CamFo/SecurityDoor/Door/Schéma/Mesure/M1 Porte derrière.jpg

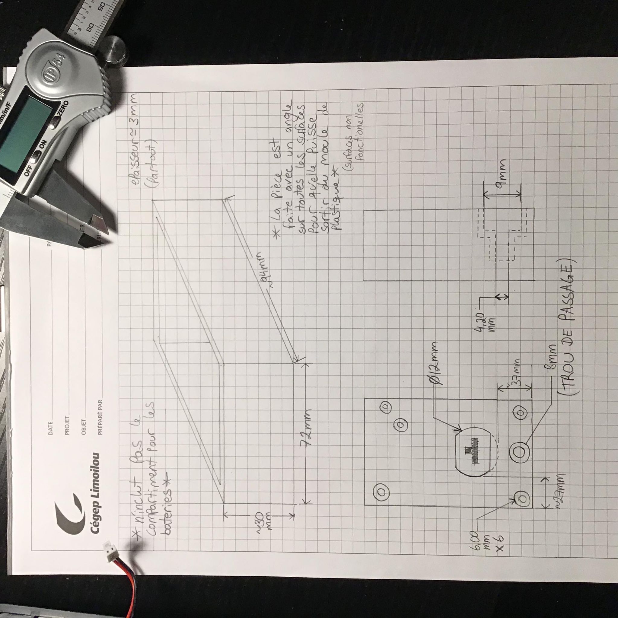
Door/Schéma/Mesure/M1 Porte derrière.jpg
