CamFo/SecurityDoor/Door/Schéma/Fusion 360/3.JPG

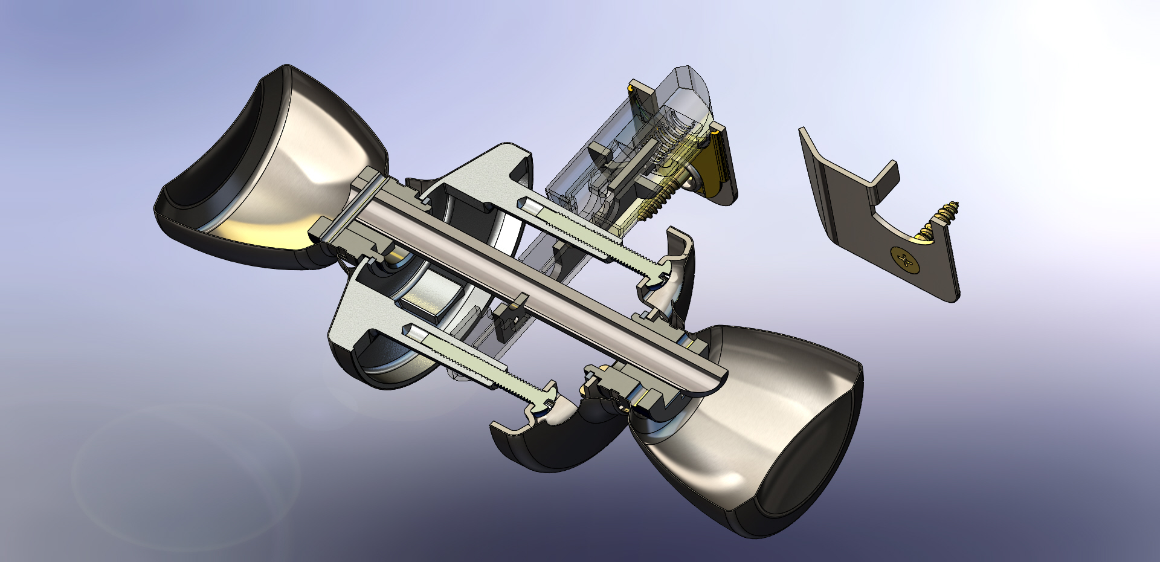
Door/Schéma/Fusion 360/3.JPG
