CamFo/SecurityDoor/README.md

# SecurityDoor
The repository to put all file necessary for the final project of TSO
