CamFo/SecurityDoor/Door/Schéma/Revue de conception/liste_de_revue_de_conception.xlsx

Sheet: Schéma électrique
Revue Conception
Date: | 2023-04-17
Responsable:
Participants: | Ilyes Gharmoul
Schéma Électrique |  |  |  | C/NC/NA
item | Détails de vérification | Catégorie | Requis | Conformité | notes
1 | La cartouche a été bien remplie identifiant le nom du projet, nom de l'organisation, le nom du PCB, le nom du dessinateur, une date de révision | dessin |  | Conformité
2 | La patte 1 de tous les connecteurs est identifiée clairement et définie au niveau de l'empreinte(footprint) | dessin |  | Conformité | J4 de la page de drive moteur est techniquement conforme mais possède les pins "L et R" pour Left and Right pour souder le connecteur au ground (les supports)
3 | Vérifier que chaque pièce est bien liée a la bonne empreinte dans Altium. | dessin |  | Conformité
4 | Identifier tous footprint non standards (gros condensateurs, grosses résistances) | dessin |  | NA | Tous standards
5 | Les pattes d'alimentation et de ground (terre) sont bien définis. Les traces critiques (puissance, impedances controlées, bus) identifiées | dessin |  | Conformité | seul grande puissance potentielle (>1A) est la bande LED sinon il y a le USB qui doit avoir du differentiel
6 | Les symboles d'alimentation ne sont pas dirigés vers le bas et les symboles de gnd ne sont pas dirigés vers le haut | dessin |  | Conformité
7 | Vérifier qu'il n'y a pas d'entrées flotantes (ampli-op), grille de mosfet, entrées de IC | dessin |  | Conformité
8 | Vérifier les pattes des connecteurs lorsque deux cartes s'emboitent ensemble ou s'ils sont reliés par des câbles. Attention aux effets mirroirs | dessin |  | NA | Les connecteurs que j'utilise fait en sorte que s'est impossible d'inverser la connection
9 | Vérifier qu'il n'y a pas d'interférence (overlap) sur le schéma électrique | dessin
10 | Les valeurs sont-elles dans un format uniforme (résistances, condensateurs, inductances) | dessin |  | Conformité
11 | Tous les composants ont une référence et une valeur | dessin |  | Conformité
12 | Les symboles des composants sont suffisamment clairs et donnent suffisamment d'information | dessin |  | Conformité
13 | Les symboles de composants identiques sont les mêmes d'un circuit et d'une page à l'autre (attention aux copies collés) | dessin |  | Conformité
14 | Les pièces non-montées sont clairement identifiées sur le schéma électrique | dessin |  | Conformité
15 | Les références des composants utilisent des standards et sont uniformes sur tout le schéma électrique | dessin |  | Conformité | Les pièces non montées sont indiquée et les pièces qui seront peux être pas monter ( J7,J8 sur Enregistreur et Speaker Audio) aussi.
16 | On n'utilise pas de point décimaux (elles pourraient disparaitre dans le processus d'impression) | dessin |  | Conformité
17 | Les points de jonction sont présents, clairement identifiés et respectent les normes (pas de connexions en 4 voix) | dessin
18 | Les liens(nets) sont correctement branchés et accrochés sur le schéma électrique | dessin |  | Conformité
19 | Tous les liens orphelins doivent être identifiés ou éliminés | dessin |  | Conformité
20 | Le schéma est lisible lorsque imprimé dans le format de papier disponible | dessin |  | Conformité
21 | Le schéma devrait logiquement se lire gauche vers la droite, haut vers le bas | dessin |  | Conformité
22 | Les composants séparés en sections doivent être clairement identifiés (ampli, MCU, portes logiques) | dessin |  | Conformité | Ils sont séparer par page
23 | Les composants choisis sont-ils disponibles en quantité suffisante et prévus dans les délais | composants |  | Conformité
24 | Les composants choisis ont-ils des sources alternatives ou prévoir multiples empreintes | composants |  | Conformité | 2 type de conn USB, des connecteurs sur les IO au cas ou, et conn sur IDS au cas ou aussi.
25 | Les composants choisis sont-ils actifs (prévenir l'obsolescence) | composants |  | Conformité
26 | Les fiches techniques sont-elles facilement disponibles, claires et est ce qu'il y a des errata | composants |  | Conformité | et les datasheets sont dans notre database
27 | Vérifier les suffixes des composants choisis (footprint, température, précision) | composants |  | Conformité
28 | Vérifier que le bon type de condensateur soit utilisé (tantalum, electrolytique, ceramique) selon sa fonction | composants |  | Conformité
29 | Pour les composants SPI avec communication commune, est-ce qu'elles ont leur chip select connecté individuellement | signaux |  | Conformité
30 | Les fonctions de reset sont correctement filtrées | signaux |  | Conformité
31 | Vérifier les pull-up pour les bus I2C | signaux |  | Conformité
32 | Les différents bus et signaux sont-ils affectés aux bons ports et connecteurs | signaux |  | Conformité
33 | Vérifier les niveaux logiques des pattes digitales des IC (reset, select, disable, double fonctions) | signaux
34 | Vérifier s'il faut ajouter des pull-ups ou pull-down sur les pattes du MCU pour prévenir les problèmes lorsque le MCU est en reset (I/O haute impédance) | signaux |  | Conformité
35 | Les I/O des MCU sont clairement identifiées (sens des flèches: entrées ou sorties) | signaux |  | NA
36 | Des résistances en séries sont-elles nécessaires pour les signaux de communication rapides | signaux
37 | Pour des composants I2C, les adresses sont-elles définies et uniques | signaux |  | Conformité
38 | Les protections du circuit nécessaires sont-elles en place : Fusibles, diodes TVS | conception |  | Conformité
39 | Les règles électriques ont-elles été bien définies, respectées et validées (ERC) ? | conception |  | Conformité
40 | Vérifier la liste des connections (Netlist). Vérifier qu'il n'y a pas de liens orphelins ou un nom trop similaire(ex: 3V3 ou 3.3V) | conception |  | Conformité
41 | Vérifier la tension de tous les composants ( Condensateurs, régulateurs, protections) avec marge suffisante | conception |  | Conformité
42 | Est-ce que les règles de DRC sont bien définis et les erreurs DRC corrigés ou les avis (warnings) bien analysés | conception |  | Conformité
43 | Y-a-t-il des test points pour le gnd ainsi que pour les signaux critiques (I2C, UART, PWM,ADC, Alimentations) | conception |  | Conformité
44 | Les IC sont correctement découplés. Attention si plusieurs pattes d'alimentation sur un chip. La règle: 1 alim = 1 découplage | conception |  | Conformité
45 | Les entrées provenant de l'extérieur du PCB sont correctement protégés contre les DES(ESD) | conception |  | Conformité | TVS
46 | Les entrées sorties de cartes mémoires externes (ex: SD ou micro-SD) sont correctement protégées contre les DES(ESD) | conception |  | NA
47 | Les composants polarisés sont protégés contre une tension inverse | conception |  | NA | Connecteur rend la mauvaise polarisation impossible
48 | Les circuits permettant de programmer le MCU a été vérifié. Les I/O nécessaires prévus | conception |  | Conformité
49 | Des filtres sont-ils nécessaires entre des sections digitales et analogiques | conception |  | NA
50 | Des liens ''Spares'' sont tirés vers des tests points pour chaque MCU (idéalement 2) | conception |  | Conformité | Test poins et connecteurs sur les ios

Sheet: Circuit imprimé
Revue Conception
Date:
Responsable:
Participants:
Circuit imprimé
item | Détails de vérification | Catégorie | Requis | Conformité | notes
1 | Les composants sont le plus possible alignés suivant une grille et disposés 0,90,180,270 degrés | dessin
2 | Les composants sont facilement accessibles pour l'inspection, l'assemblage automatisé ou manuel et pour le remplacement | dessin
3 | Les boutons sont orientés logiquement, les potentiomètres orientés dans le même sens | dessin
4 | Des dégagements de cuivre et de tous métaux pour les modules RF avec antenne intégrés | dessin
5 | Des dégagements suffisants entre les pièces qui dégagent de la chaleur et les pièces sensibles à la température (ex: mems IMU) | dessin
6 | Un anneau de garde d'au moins 50 mils est prévu autour du pcb et un dégagement suffisant entre le cuivre et le contour extérieur au circuit imprimé | dessin
7 | Est-ce que des ''golds fingers'' sont nécessaires | dessin
8 | Le PCB doit-il être mis en panneau. Si oui, prévoir la méthode de dépannelisation | dessin
9 | Le ''Stackup'' est défini | dessin
10 | Le Fini du PCB est établi et le design en tient compte (or, étain, Argent, ROHS) | dessin
11 | L'épaisseur du fini est défini (1/2oz, 1oz…) attention aux trapèzes pour fini supérieur à 1 oz | dessin
12 | Les ouvertures dans le masque de soudure sont définies pour assemblage automatisé ou stencil | dessin
13 | Valider les tolérances du fabricant de PCB: ''solder mask'', ''silkscreen'', traces, trous, distance minimum entre les traces | dessin
14 | Au minimum trois ''Fiducials'' ont été ajoutés au PCB pour l'assemblage automatisé | dessin
15 | La patte 1 est clairement visible avant et après assemblage sur les IC | dessin
16 | Les composants polarisés (diodes, condensateurs, etc) sont clairement indiqués sur le circuit imprimé | dessin
17 | Pour les cartes de développement, un marquage a toutes les 5/10 pattes est suggérée | dessin
18 | Les dimensions de l'empreinte a été vérifiée par le dessinateur et aussi validé par un collègue(fortement recommandé): top ou bottom view, dimensios des pads, dimensions entre les pads, solder mask entre les pads, dimensions des trous, marquage, identification patte 1, dégagements sous la pièce si nécessaire, pads thermiques | dessin
19 | Gestion des pads thermiques exposés et gestion de la connexion sur le bon net avec suffisamment de vias | dessin
20 | Le ''outline'' du PCB est défini | dessin
21 | Éviter les angles parfaitement droits pour les contours (mettre des rayons de courbure). Cela nécessite une fraise très petite et augmente les coûts du pcb | dessin
22 | Toutes les traces sont connectées | dessin
23 | Les recommandations du manufacturier ont été suivi au niveau du placement des pièces pour les MCU, les convertisseurs, les régulateurs DC-DC, les modules RF, etc… | dessin
24 | Toutes les couches ont été vérifiés | dessin
25 | Des ''thermals reliefs'' sont ajoutés sur les pattes surtout reliées aux plans de masses et plans d'alimentation | dessin
26 | Il n'y a pas de traces à 90 degrés (acid traps) | dessin
27 | La grosseur des traces est adaptée au courant qui circule afin d'éviter l'échauffement ou les pertes de tension | dessin
28 | Les vias sont suffisament gros et adaptés à la grosseur des traces | dessin
29 | Le nom du circuit imprimé est indiqué et un espace pour numéro de série idéalement | dessin
30 | Les connecteurs ont des noms clairs pour aider le branchement | dessin
31 | Aucun ''silkscreen'' sur les pads | dessin
32 | Ne pas avoir de composants électroniques (IC, condensateurs, diodes) plus près de 50 mils du bord du PCB | dessin
33 | Les connecteurs de ''debug'' sont-ils accessibles | mécanique
34 | Les contraintes mécaniques ont été établies et vérifiés (dimensions pcb, bosses fixations, interférences mécaniques, connecteur, interface usager) | mécanique
35 | Les ''Keep out'' sont respectés autour des connecteurs, des trous de montage, des outils d'extraction, des outils de programmation, des outils d'assemblage (tournevis, etc) | mécanique
36 | Les trous de fixations sont-ils isolés électriquement, reliés à la masse ou a un autre ''net'' | mécanique
37 | Est-il possible de brancher débrancher facilement les connecteurs avec les doigts | mécanique
38 | Un modèle 3D a été validé dans le boitier mécanique du produit afin de valider la hauteur des pièces, les connecteurs, les trous de fixation | mécanique
39 | Les filtres sont proches de la source (transmetteur) | conception
40 | Les résistances de terminaison sont proches du recepteur | conception
41 | Les condensateurs de découplage sont placés le plus près possible des IC | conception
42 | Les masses analogiques et numériques sont reliés idéalement en un seul point | conception
43 | Le ERC a-t-il été passé, les erreurs corrigées ou analysées | conception
44 | Les traces à impédance contrôlées ont été gérés correctement | conception
45 | Les lignes de transmission sont gérées correctement | conception
46 | Y-a-t-il une ligne de garde autour des crystaux | conception
47 | Y-a-t-il des filtres sur les entrées ADC | conception
48 | 'Drivers'' et ''Receivers'' placés proche des connecteurs | conception
49 | Pas de traces autour des composants sensibles | conception
50 | Éviter les traces sous un composant bruité | conception
51 | Ne pas avoir de ''GND LOOP'' | conception
52 | Les pistes hautes tensions respectent les normes de sécurités applicables au produit | sécurité

Sheet: Bom
Revue Conception
Date:
Responsable:
Participants:
Bom
item | Détails de vérification | Catégorie | Requis | Conformité | notes
1 | Le bom a été généré et comprend au moins une révision, date de révision, nom du Bom, auteur | bom
2 | Les colonnes mimimales doivent être: item, qté, numéro manufacturier, description, référence (designator) | bom
3 | Des options peuvent aussi être ajoutées: numéro interne, coût, distributeur, manufacturier, status, empreinte, valeurs, SMT ou traversant | bom
4 | Vérifier qu'il n'y a pas de doublons dans les numéro de référence (designator) | bom
5 | Vérifier que la quanité inscrite correspond au nombre de numéro de référence (designator) | bom
6 | Vérifier qu'il n'y a pas de doublons de lignes dans les valeurs (ex: 0.1uF, resistances) | bom
7 | Vérifier si on peut remplacer une pièce par une autre pour faire diminuer le nombre de pièces (ex: pull-up ou condensateurs avec 2 footprints différents) | bom
8 | Identifier clairement dans le bom les pièces non-montées | bom
9 | Des notes de montages sont-elles nécessaires pour assembler le PCB | bom
10 | un fichier d'assemblage (XY) a été généré pour l'assemblage automatisé | bom

Sheet: Actions
Revue Conception
Date:
Responsable:
Participants:
Actions
No. | Détail de l'action | Responsable

Sheet: Liens utiles
Liens de référence
https://pcbchecklist.com/
PCB Layout & Routing (https://www.electronics-notes.com/articles/analogue_circuits/pcb-design/pcb-layout-routing.php)
EEVblog #1129 - Creating a Nice Readable Schematic (https://www.youtube.com/watch?v=R_Ud-FxUw0g)
How were schematics drawn before CAD? - Stack Exchange (https://electronics.stackexchange.com/questions/308878/how-were-schematics-drawn-before-cad)
https://www.volersystems.com/blog/design-tips/91-pcb-layout-checklist
