CamFo/SecurityDoor/Capteurs/Architecture/ArchitectureLogicielCapteurs.png

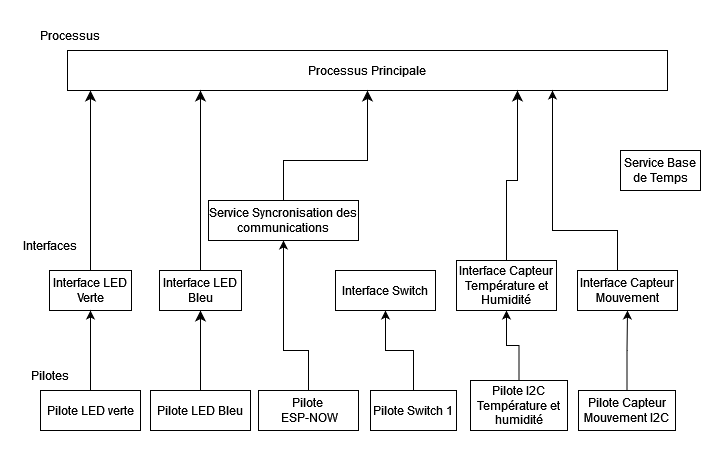
Capteurs/Architecture/ArchitectureLogicielCapteurs.png
