CamFo/SecurityDoor/Capteurs/Architecture/ArchitectureÉlectroniqueCapteurs.png

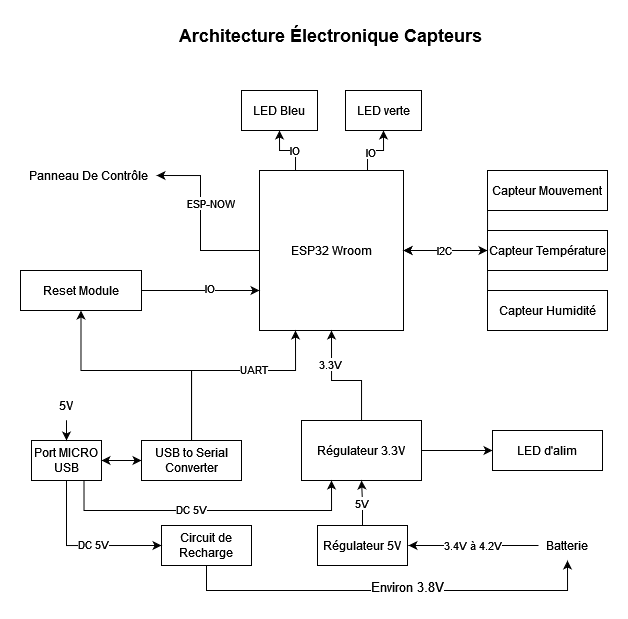
Capteurs/Architecture/ArchitectureÉlectroniqueCapteurs.png
