CamFo/SecurityDoor/Door/Schéma/Diagramme/Arch lo ex 1.drawio.png

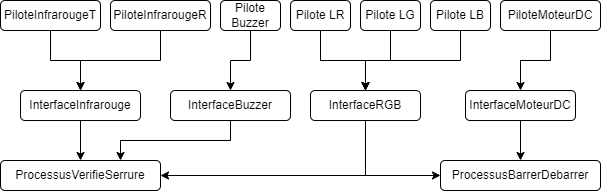
Door/Schéma/Diagramme/Arch lo ex 1.drawio.png
