CamFo/SecurityDoor/Door/Schéma/Diagramme/Arch lo ex 2.drawio (1).png

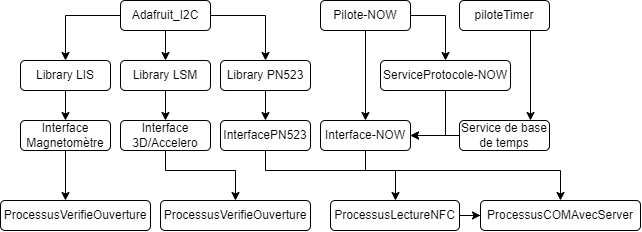
Door/Schéma/Diagramme/Arch lo ex 2.drawio (1).png
