CamFo/SecurityDoor/Door/Schéma/Diagramme/Architecture logicelle exclave.drawio (1).png

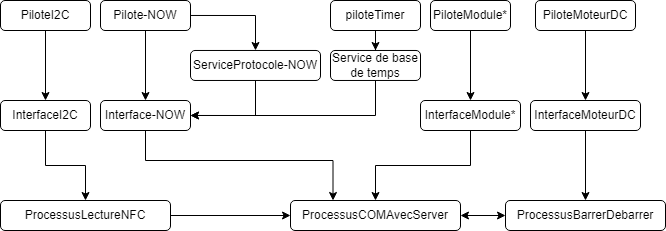
Door/Schéma/Diagramme/Architecture logicelle exclave.drawio (1).png
