CamFo/SecurityDoor/Door/Schéma/Diagramme/Architecture Materiel  Door.png

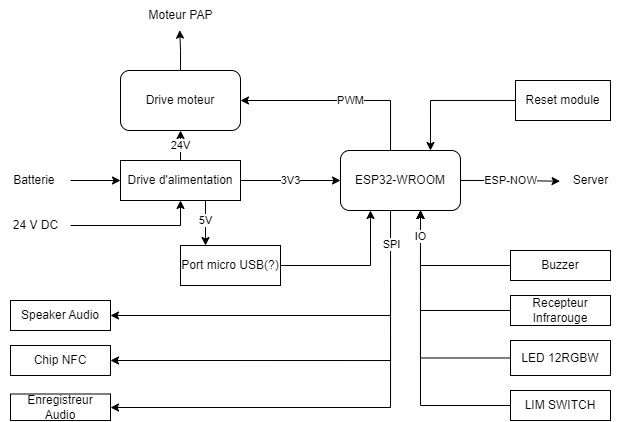
Door/Schéma/Diagramme/Architecture Materiel Door.png
