CamFo/SecurityDoor/Door/Schéma/Fusion 360/1.jpg

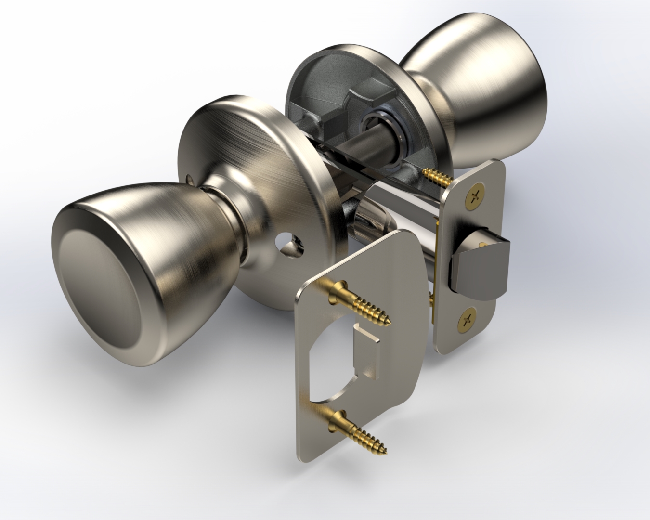
Door/Schéma/Fusion 360/1.jpg
