CamFo/SecurityDoor/Door/Schéma/Fusion 360/2.jpg

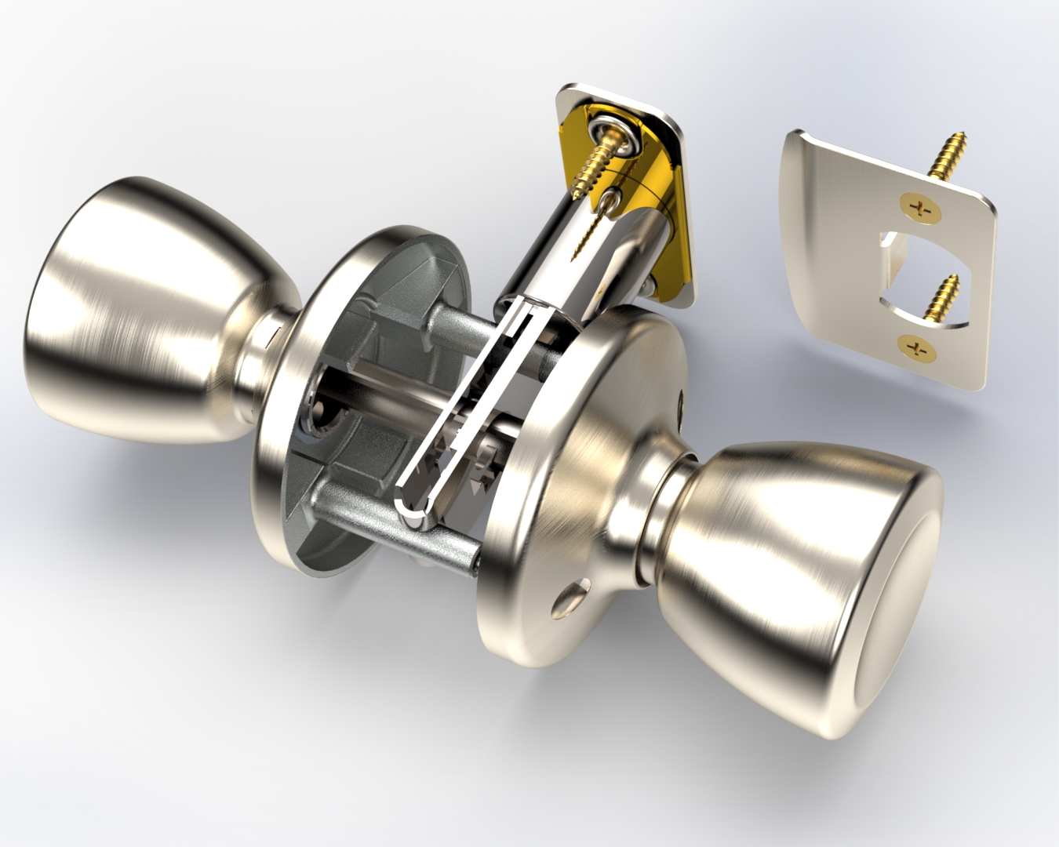
Door/Schéma/Fusion 360/2.jpg
