CamFo/SecurityDoor/Door/Schéma/Fusion 360/4.JPG

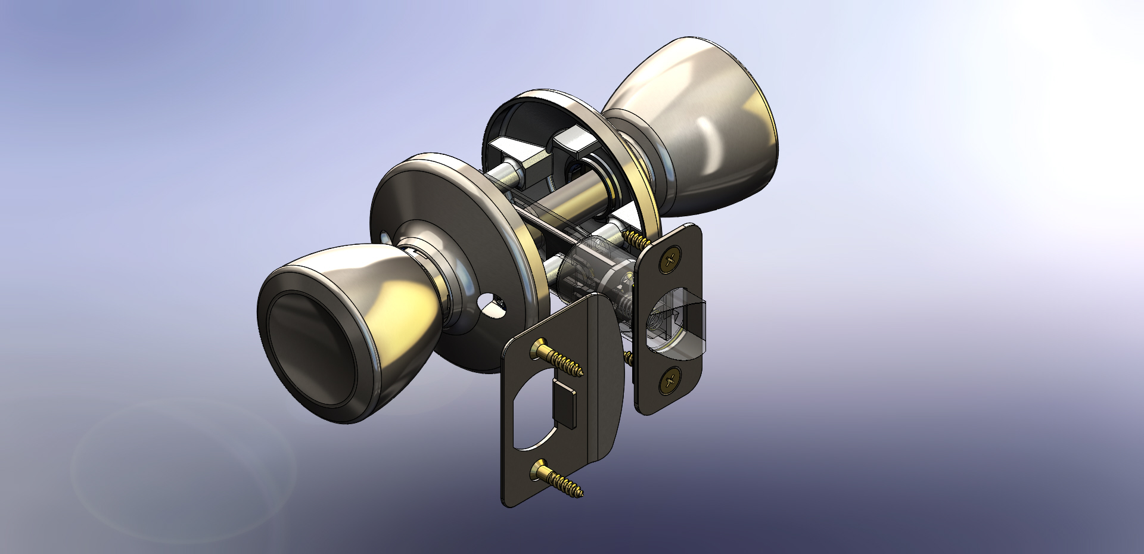
Door/Schéma/Fusion 360/4.JPG
