CamFo/SecurityDoor/Door/Schéma/Fusion 360/5.JPG

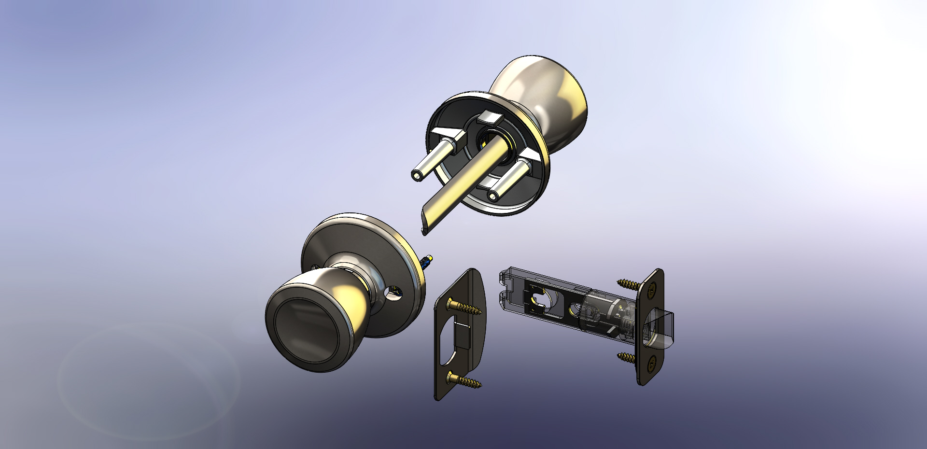
Door/Schéma/Fusion 360/5.JPG
