CamFo/SecurityDoor/Door/Schéma/Fusion 360/6.JPG

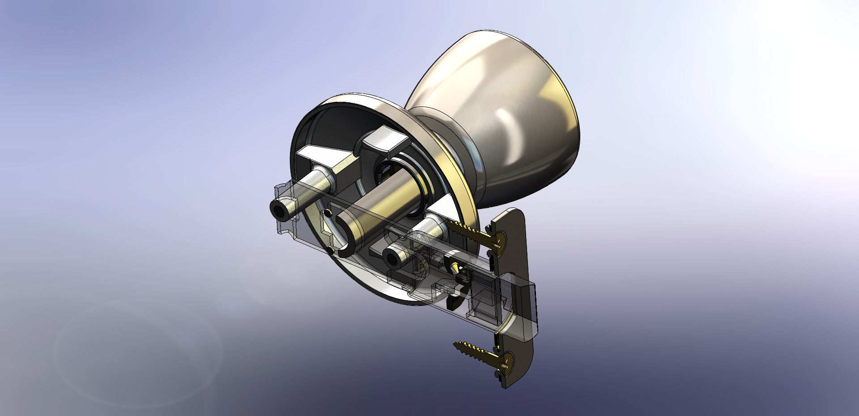
Door/Schéma/Fusion 360/6.JPG
