CamFo/SecurityDoor/Door/Schéma/Fusion 360/Rack and Pinion Gear Animated.gif

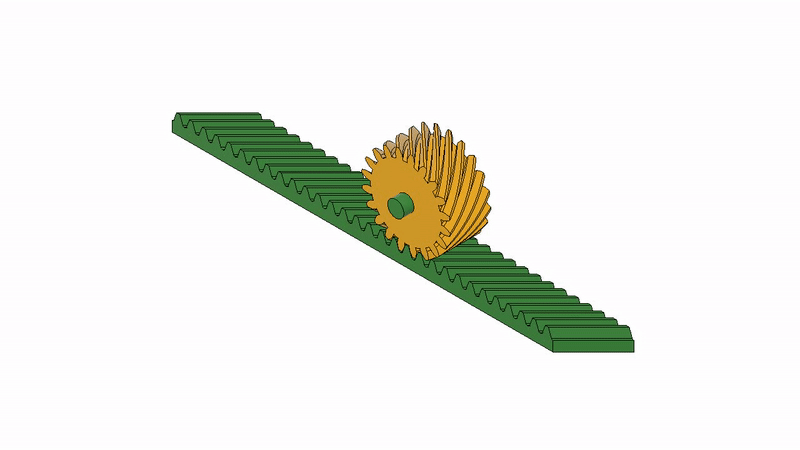
Door/Schéma/Fusion 360/Rack and Pinion Gear Animated.gif
