CamFo/SecurityDoor/Door/Schéma/Fusion 360/Rack and pinion gear drawing..jpg

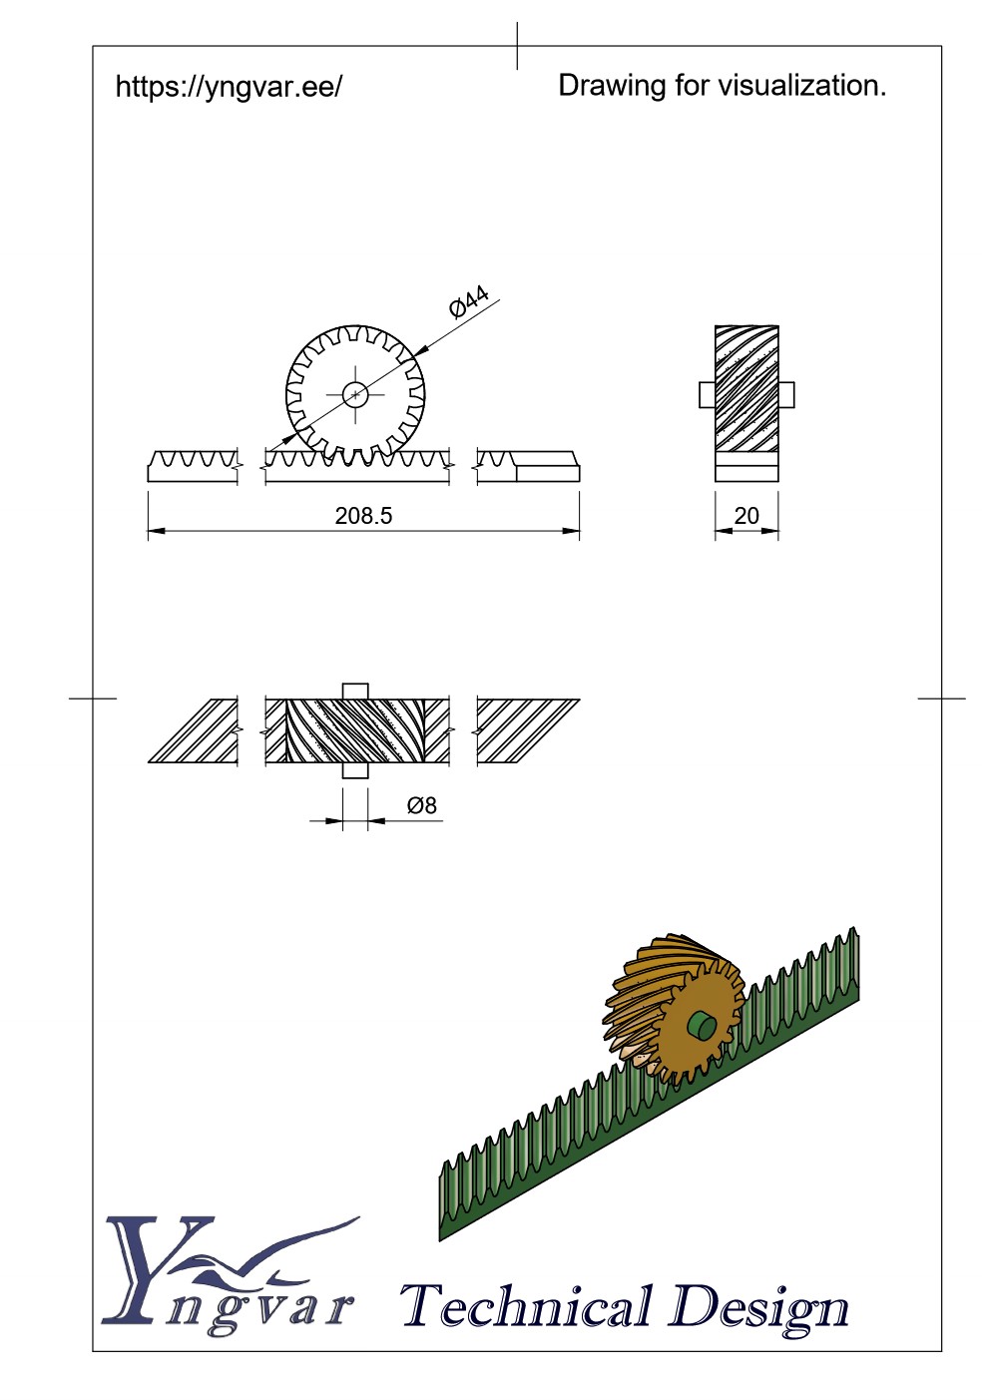
Door/Schéma/Fusion 360/Rack and pinion gear drawing..jpg
