CamFo/SecurityDoor/Door/Schéma/Fusion 360/Rack and Pinion Gear Transparent Image.png

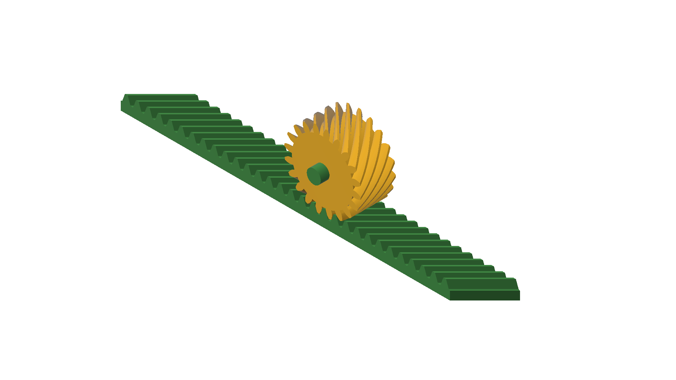
Door/Schéma/Fusion 360/Rack and Pinion Gear Transparent Image.png
