CamFo/SecurityDoor/Door/Schéma/Fusion 360/Rack and Pinion Gear..gif

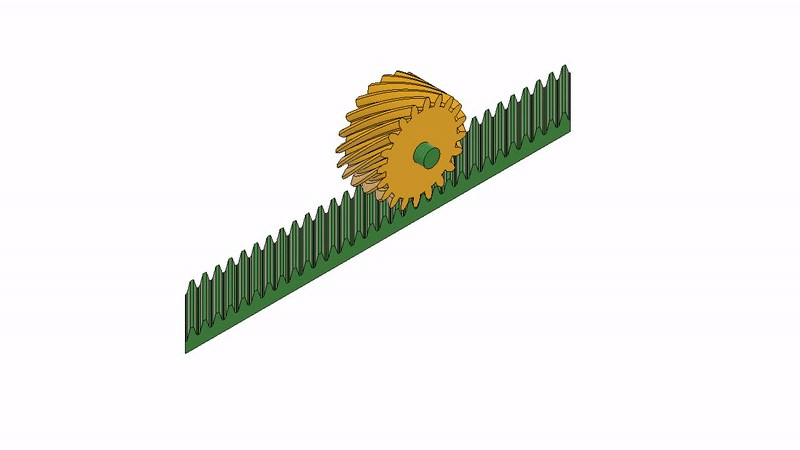
Door/Schéma/Fusion 360/Rack and Pinion Gear..gif
