CamFo/SecurityDoor/Door/Schéma/Fusion 360/Rack and Pinion Gear.jpg

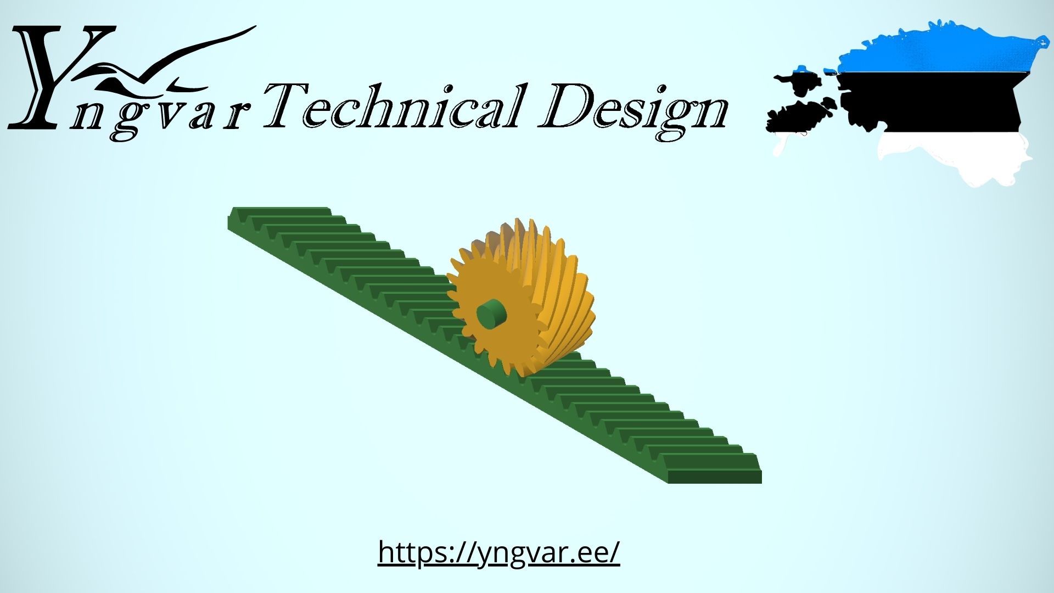
Door/Schéma/Fusion 360/Rack and Pinion Gear.jpg
