CamFo/SecurityDoor/Door/Schéma/Fusion 360/Rack and Pinion Gear.png

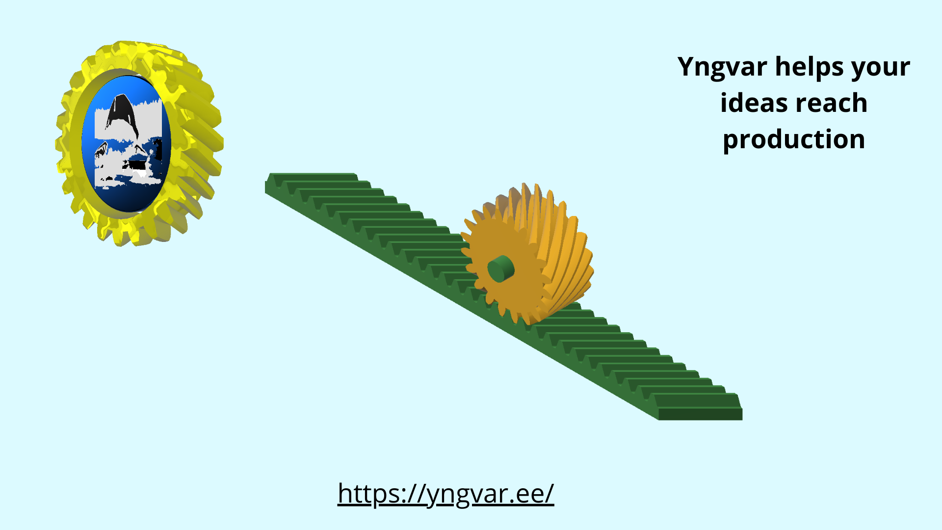
Door/Schéma/Fusion 360/Rack and Pinion Gear.png
