CamFo/SecurityDoor/Door/Schéma/Mesure/M2 Porte derrière.jpg

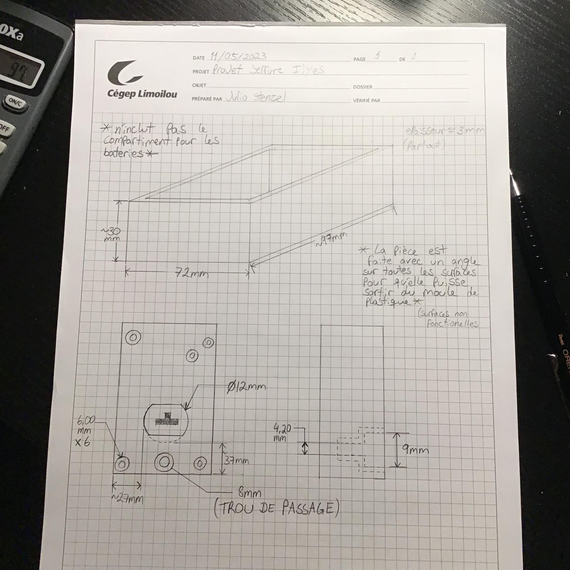
Door/Schéma/Mesure/M2 Porte derrière.jpg
