CamFo/SecurityDoor/Panneau/Architecture/ArchitectureLogicielPanneau.png

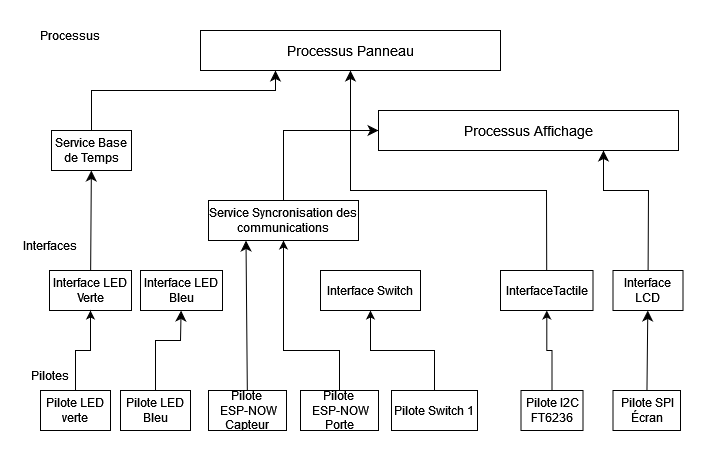
Panneau/Architecture/ArchitectureLogicielPanneau.png
