CamFo/SecurityDoor/Panneau/Architecture/ArchitectureÉlectroniquePanneau.png

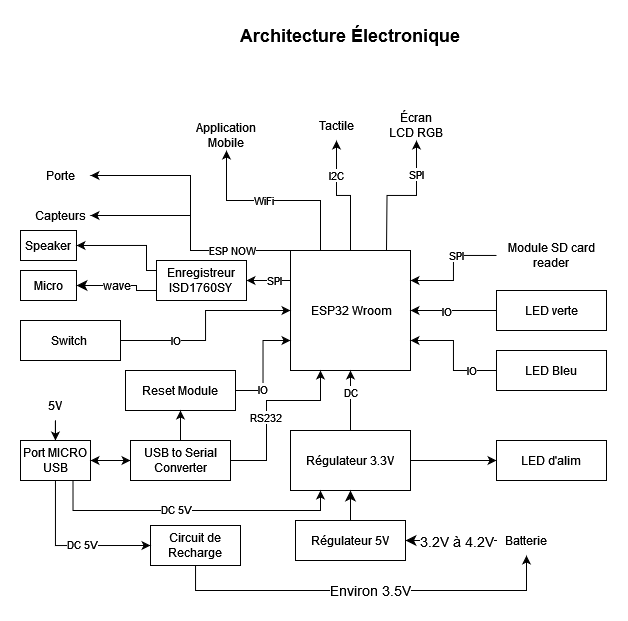
Panneau/Architecture/ArchitectureÉlectroniquePanneau.png
