CamFo/SecurityDoor/Schema Global/Architecture Systeme.drawio (1).png

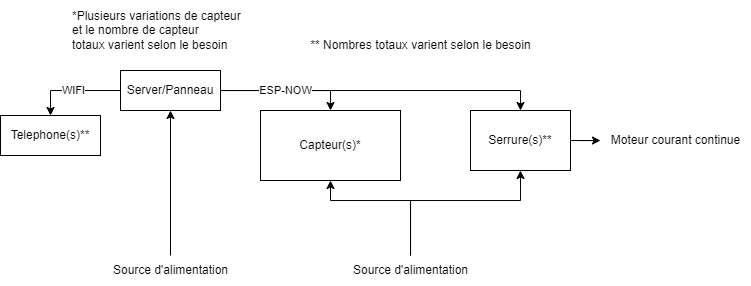
Schema Global/Architecture Systeme.drawio (1).png
