CamFo/SecurityDoor/Schema Global/Architecture Systeme.drawio.png

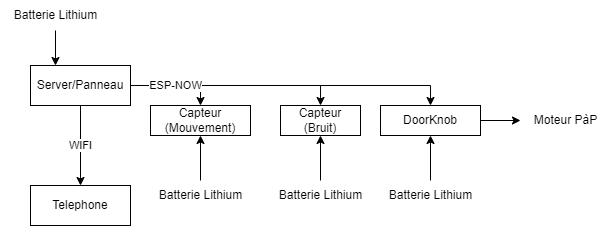
Schema Global/Architecture Systeme.drawio.png
