CamFo/SecurityDoor/Door/Altium/DPIAT202303_DOOR/BOM/DPIAT202303_DOOR.xlsx

Comment | Description | Quantity | Manufacturer Part Number 1 | ADAM Inventory Number 1
USB-UART CP2102N | USB Interface IC USBXpress - USB to UART Bridge QFN24 | 1 | CP2102N-A02-GQFN24 | E00002
USB - mini B | CONN RCPT MINI USB B 5POS SMD RA | 1 | 10033526-N3212LF | E00003
USB4105-GF-A | USB-C (USB TYPE-C) USB 2.0 Receptacle Connector 24 (16+8 Dummy) Position Surface Mount, Right Angle; Through Hole | 1 | USB4105-GF-A | E00005
TVS Diode 5.5V | 8.5V Clamp Ipp Tvs Diode Surface Mount SOT-143-4 | 1 | SP0503BAHTG | E00006
MMBT2222AM3T5G | TRANS NPN 40V 0.6A SOT-723 | 2 | MMBT2222AM3T5G | E00007
N-CH 30V 5.8A SOT23 | N-Channel 5.8A (Tj) 350mW Surface Mount SOT-23 | 1 | DMN3051L-7 | E00008
Dip Switch 3P | Dip Switch SPST 3 Position Surface Mount Slide (Standard) Actuator 25mA 24VDC | 2 | A6S-3102-H | E00009
TEST POINTS | RCWCTE TEST POINTS | 11 | RCWCTE | E00009
KMR741NG ULC LFS | SWITCH TACTILE SPST-NO 50MA 32V | 1 | KMR741NGULCLFS | E00012
499K | RES SMD 499K OHM 1% 1/4W 0603 | 1 | RC0603FR-07499KL | E00016
47K | RES SMD 47K OHM 5% 1/4W 0603 | 1 | AC0603FR-0747KL | E00017
21.5K | RES SMD 21.5K OHM 0.1% 1/5W 0603 | 1 | CRCW060321K5FKEA | E00018
150R | RES SMD 150 OHM 0.1% 1/8W 0603 | 5 | RC0603FR-07150RL | E00020
10K | RES SMD 10K OHM 1% 1/10W 0603 | 7 | RC0603FR-0710KL | E00021
100K | RES SMD 100K OHM 1% 1/4W 0603 | 2 | RC0603FR-07100KL | E00022
100R | RESISTOR 100 Ohm SMD 1% 1/10W | 1 | AC0603FR-10100RL | E00023
30R | RES 30 OHM 1% 1/3W 0603 | 1 | SG73P1JTTD30R0F | E00026
22.1K | RES 22.1K OHM 1% 1/10W 0603 | 1 | RMCF0603FT22K1 | E00027
1K | RES 1K OHM 1% 1/4W 0603 | 2 | SR0603FR-7T1KL | E00028
NA | No resistance, just in case | 7 | RC0603JR-070RL | E00032
MP28167GQ-P | Buck-Boost Switching Regulator IC Positive Fixed 5V 1 Output 3A 16-PowerVFQFN | 1 | MP28167GQ-P | E00033
LSM6DSMTR | Accelerometer, Gyroscope, Temperature, 6 Axis Sensor I²C, SPI Output | 1 | LSM6DSMTR | E00036
LIS3MDLTR | Magnetoresistive Sensor X, Y, Z Axis 12-LGA (2x2) | 1 | LIS3MDLTR | E00037
LD1117S33TR | IC REG LINEAR 3.3V 800MA SOT223 | 2 | LD1117S33TR | E00040
4.7 µH | FIXED IND 4.7UH 4.6A 53 MOHM SMD | 1 | SRP5030T-4R7M | E00042
Fuse 500mA | FUSE BOARD MNT 500MA 125VAC/VDC | 1 | 3413.0113.22 | E00043
ESP32-WROOM-32 (8MB) | No Description Available | 1 | ESP32-WROOM-32D-N4 | E00044
DRV8837CDSGT | Motor Driver NMOS PWM 8-WSON (2x2) | 1 | DRV8837CDSGT | E00045
B2B-PH-K-S(LF)(SN) | CONN HEADER VERT 2POS 2MM | 1 | B2B-PH-K-S-LF-SN | E00051
CONN JST 2P SM 90DEG | CONN SM JST 2P | 2 | S2B-PH-SM4-TB(LF)(SN) | E00052
B10B-PH-K-S(LF)(SN) | CONN HEADER VERT 10POS 2MM | 1 | B10B-PH-K-S(LF)(SN) | E00053
NPPN041BFCN-RC | CONN HDR 4POS 0.079 GOLD | 1 | NPPN041BFCN-RC | E00054
SSW-102-03-T-S | CONN RCPT 2POS 0.1 TIN | 1 | SSW-102-03-T-S | E00055
4.7 µF | CAP CER 4.7UF 25V X5R 0603 | 2 | CL10A475KA8NQNC | E00056
22nF | CAP CER 22pF 15V 10% 0603, X7R | 2 | EMF107B7223KAHT | E00057
1 µF | CAP CER 1UF 16V X7R 0603 | 3 | C0603C105K4RACAUTO | E00058
10 µF | CAP CER 10UF 6.3V X5R 0603 | 1 | GRM188R60J106ME47D | E00059
0.1 µF | CAP CER 0.1UF 50V X7R 0603 | 13 | C0603C104K5RAC7411 | E00060
10 µF | CAP ALUM 10UF 20% 16V SMD | 3 | UWX1C100MCL1GB | E00062
100 µF | CAP ALUM 100UF 20% 50V SMD | 5 | UWT1H101MNL1GS | E00063
PPTC121LFBN-RC | CONN RCPT 12POS 0.1 GOLD PCB | 3 | PPTC121LFBN-RC | E00067
Yellow | 0603 YELLOW | 1 | BL-HKC36D-AV-TRB | E00068
Red | 0603 RED LED | 3 | BL-HUB36A-AV-TRB | E00069
Green | LED GREEN 0603 SMD | 2 | 597-3316-507F | E00070
Blue | Blue 470nm LED Indication - Discrete 3.3V 0603 (1608 Metric) | 1 | APT1608LVBC/D | E00071
22 µF | CAP ALUM 22UF 20% 16V SMD | 1 | EEE-1CA220WAR
IR Sensor TSOP38338 | Ir Remote Receiver 38KHZ 45M 3-PIN | 1 | TSOP38338 | E00019
TSAL6100 | Infrared (IR) Emitter 940nm 1.35V 100mA 80mW/sr @ 100mA 20° Radial, 5mm Dia (T 1 3/4) | 1 | TSAL6100 | E00001
