CamFo/SecurityDoor/Door/Altium/DPIAT202304_FRONTDOOR/DPIAT202304_FRONTDOOR/BOM/DPIAT202304_FRONTDOOR.xlsx

Description | Comment | Quantity | Manufacturer Part Number 1 | ADAM Inventory Number 1
CAP CER 0.1UF 50V X7R 0603 | 0.1 µF | 6 | C0603C104K5RAC7411 | E00060
CAP ALUM 4.7UF 20% 35V SMD | 4.7 µF | 5 | EMVE350ADA4R7MD55G | E00061
RES 4.7K OHM 1% 1/10W 0603 | 4.7K | 3 | RC0603FR-074K7L | E00025
RES SMD 10K OHM 1% 1/10W 0603 | 10K | 4 | RC0603FR-0710KL | E00021
FOOTPRINT FOR TEST OR JUST IN CASE | 12P FOOTPRINT | 2 | PPTC121LFBN-RC | E00074
RES SMD 80.6K OHM 1% 1/4W 0603 | 80.6K | 1 | ERJ-3EKF8062V | E00015
RES SMD 100K OHM 1% 1/4W 0603 | 100K | 2 | RC0603FR-07100KL | E00022
RES SMD 150 OHM 0.1% 1/8W 0603 | 150R | 1 | RC0603FR-07150RL | E00020
SMT 8.7 X 3.0 MM MINI SLIDE SWIT | 450405020524 | 1 | 450405020524 | E00013
SWITCH PUSH SPST-NO 0.4VA 28V | AB11AH-HC | 1 | AB11AH-HC | E00066
CONN HEADER VERT 2POS 2MM | B2B-PH-K-S(LF)(SN) | 1 | B2B-PH-K-S(LF)(SN) | E00051
CONN HEADER VERT 10POS 2MM | B10B-PH-K-S(LF)(SN) | 1 | B10B-PH-K-S(LF)(SN) | E00053
Voice Record/Playback IC Multiple Message 40 ~ 120 Sec Pushbutton, SPI 28-SOIC | ISD1760SY | 1 | ISD1760SY | E00041
SWITCH TACTILE SPST-NO 50MA 32V | KMR741NG ULC LFS | 6 | KMR741NG ULC LFS | E00012
TERM BLK 2P SIDE ENT 2.54MM PCB | Microphone | 1 | 282834-2 | E00011
N-Channel 5.8A (Tj) 350mW Surface Mount SOT-23 | N-CH 30V 5.8A SOT23 | 4 | SI3404-TP | E00008
0603 RED LED | Red | 1 | BL-HUB36A-AV-TRB | E00069
TERM BLK 2P SIDE ENT 2.54MM PCB | Speaker | 1 | 282834-2 | E00011
CONN RCPT 2POS 0.1 TIN | SSW-102-03-T-S | 1 | SSW-102-03-T-S | E00055
TERM BLK 4P SIDE ENT 2.54MM PCB | TERM BLK 4P SIDE ENT 2.54MM PCB | 1 | 282834-4 | E00010
RCWCTE TEST POINTS | TEST POINTS | 2 | RCWCTE | E00009
Buzzers Indicator, Internally Driven Magnetic 5 V 30mA 3.1kHz 83dB @ 5V, 10cm Through Hole PC Pins | WST-1206BX-17 | 1 | WST-1206BX-17 | E00001
