CamFo/SecurityDoor/Door/Altium/DPIAT202304_FRONTDOOR/DPIAT202304_FRONTDOOR/BOM/DPIAT202304_FRONTDOOR_CELESTIAL.xlsx

Component List
PCB Design | DPIAT202304_FRONTDOOR.PrjPcb
Project | DPIAT202304_FRONTDOOR.PrjPcb |  | Variant | None |  | Report Date | 2023-04-11
Description | Device Package | Quantity | Designator | #Column Name Error:' Layer | manufacturer | #Column Name Error:' Part Number | Supplier 1 | Supplier Part Number 1 | price
CAP CER 0.1UF 50V X7R 0603 | 0603 (1608 Metric) | 6 | C? |  | KEMET |  | DigiKey | 399-C0603C104K5RAC7411CT-ND | 0.01
CAP ALUM 4.7UF 20% 35V SMD EMVE350ADA4R7MD55G | Radial, Can - SMD | 5 | C? |  | United Chemi-Con |  | Mouser | 661-EMVE350ADA4R7MD5 | 0.06
RES 4.7K OHM 1% 1/10W 0603 RMCF0603FT4K70 | 0603 (1608 Metric) | 3 | R? |  | Stackpole Electronics Inc |  | DigiKey | RMCF0603FT4K70CT-ND | 0.01
RESHIGHPOWER 0603 10K 1% 1/4W TC | 0603 (1608 Metric) | 4 | R? |  | Bourns Inc. |  | DigiKey | 118-CMP0603-FX-1002ELFCT-ND | 0.02
RES SMD 80.6K OHM 1% 1/4W 0603 RCS060380K6FKEA | 0603 (1608 Metric) | 1 | R? |  | Vishay Dale |  | DigiKey | 541-RCS060380K6FKEACT-ND | 0.02
RES SMD 100K OHM 1% 1/4W 0603 RCS0603100KFKEA | 0603 (1608 Metric) | 2 | R? |  | Vishay Dale |  | DigiKey | 541-2800-1-ND | 0.02
RES SMD 150 OHM 0.1% 1/8W 0603 MCT0603MD1500BP100 | 0603 (1608 Metric) | 1 | R? |  | Vishay Beyschlag |  | DigiKey | MCT0603-150-MBCT-ND | 0.23
SMT 8.7 X 3.0 MM MINI SLIDE SWIT |  | 1 | S? |  | Würth Elektronik |  | DigiKey | 732-450405020524CT-ND | 0.73
SWITCH PUSH SPST-NO 0.4VA 28V |  | 1 | S? |  | NKK Switches |  | DigiKey | 360-2604-ND | 5.00
CONN HEADER VERT 2POS 2MM B2B-PH-K-S(LF)(SN) |  | 1 | J? |  | JST Sales America Inc. |  | DigiKey | 455-1704-ND | 0.17
CONN HEADER VERT 10POS 2MM B10B-PH-K-S(LF)(SN) |  | 1 | J? |  | JST Sales America Inc. |  | DigiKey | 455-1712-ND | 0.46
Voice Record/Playback IC Multiple Message 40 ~ 120 Sec Pushbutton, SPI 28-SOIC |  | 1 | U? |  |  |  | Digi-Key | ISD1760SY-ND
SWITCH TACTILE SPST-NO 50MA 32V |  | 6 | S? |  | C&K |  | DigiKey | CKN10688CT-ND | 0.16
TERM BLK 2P SIDE ENT 2.54MM PCB |  | 2 | J? |  | TE Connectivity AMP Connectors |  | DigiKey | A98333-ND | 0.88
N-Channel 5.8A (Tj) 350mW Surface Mount SOT-23 |  | 4 | Q? |  | MCC |  | Digi-Key | DMN3051LDICT-ND
CONN RCPT 12POS 0.1 GOLD PCB |  | 2 | J? |  | Harwin Inc. |  | Digi-Key | S6100-ND | 0.74
0603 RED LED | 0603 (1608 Metric) | 1 | D? |  | American Bright Optoelectronics Corporation |  | DigiKey | BL-HUB36A-AV-TRBCT-ND | 0.04
CONN RCPT 2POS 0.1 TIN PCB SSW-102-03-T-S |  | 1 | J? |  | Samtec Inc. |  | DigiKey | SSW-102-03-T-S-ND | 0.53
TERM BLK 4P SIDE ENT 2.54MM PCB |  | 1 | J? |  | TE Connectivity AMP Connectors |  | DigiKey | A98335-ND | 2.68
Buzzers Indicator, Internally Driven Magnetic 5 V 30mA 3.1kHz 83dB @ 5V, 10cm Through Hole PC Pins |  | 1 | BZ? |  |  |  | Digi-Key | 433-1081-ND
