CamFo/SecurityDoor/Index Produits/INDEX_EQUIPE_ILYES_CAMILLE.xlsx

Sheet: LISTE
Nom | Liste de pièces et d'assemblage
Révision | 2023-04-11
Note
Numéro | Catégorie | Type | Nom | Description | Manufacturier | REPERTOIRE | VERSION | Remplacement: | Library Altium | Fournisseur | Manufacturer Part Number 1 | Colonne2
E00001 | Composant | Buzzer | WST-1206BX-17 | Buzzers Indicator, Internally Driven Magnetic 5 V 30mA 3.1kHz 83dB @ 5V, 10cm Through Hole PC Pins |  | E00001 | V1.00 |  | ADAM LIBRARY.SCHLIB | Digi-Key | WST-1206BX-17
E00002 | Composant | USB-UART BRIDGE | USB-UART CP2102N | USB Interface IC USBXpress - USB to UART Bridge QFN24 | Silicon Labs | E00002 | V1.00 |  | ADAM LIBRARY.SCHLIB |  | CP2102N-A02-GQFN24
E00003 | Composant | Connecteur USB | USB - mini B | CONN RCPT MINI USB B 5POS SMD RA | Amphenol ICC (FCI) | E00003 | V1.00 |  | ADAM LIBRARY.SCHLIB | DigiKey | 10033526-N3212LF
E00004 | Composant | Connecteur USB | Micro USB | USB micro connecteur TH |  | E00004 | V1.00 |  | ADAM LIBRARY.SCHLIB | Digi-Key | 1050170001
E00005 | Composant | Connecteur USB | USB4105-GF-A | USB-C (USB TYPE-C) USB 2.0 Receptacle Connector 24 (16+8 Dummy) Position Surface Mount, Right Angle; Through Hole |  | E00005 | V1.00 |  | ADAM LIBRARY.SCHLIB | Newark | USB4105-GF-A
E00006 | Composant | Diodes | TVS Diode 5.5V | 8.5V Clamp Ipp Tvs Diode Surface Mount SOT-143-4 | Littelfuse | E00006 | V1.00 |  | ADAM LIBRARY.SCHLIB |  | SP0503BAHTG
E00007 | Composant | Transistor | MMBT2222AM3T5G | TRANS NPN 40V 0.6A SOT-723 | ON Semiconductor | E00007 | V1.00 |  | ADAM LIBRARY.SCHLIB | DigiKey | MMBT2222AM3T5G
E00008 | Composant | Transistor | N-CH 30V 5.8A SOT23 | N-Channel 5.8A (Tj) 350mW Surface Mount SOT-23 | MCC | E00008 | V1.00 |  | ADAM LIBRARY.SCHLIB | Digi-Key | SI3404-TP
E00009 | Composant | Switch | Dip Switch 3P | Dip Switch SPST 3 Position Surface Mount Slide (Standard) Actuator 25mA 24VDC | CUI | E00009 | V1.00 |  | ADAM LIBRARY.SCHLIB | Mouser | DS04-254-2-03BK-SMT
E00010 | Composant | Connecteur | TERM BLK 4P SIDE ENT 2.54MM PCB | TERM BLK 4P SIDE ENT 2.54MM PCB | TE Connectivity AMP Connectors | E00010 | V1.00 |  | ADAM LIBRARY.SCHLIB | DigiKey | 282834-4
E00011 | Composant | Connecteur | TERM 2P | TERM BLK 2P SIDE ENT 2.54MM PCB | TE Connectivity AMP Connectors | E00011 | V1.00 |  | ADAM LIBRARY.SCHLIB | DigiKey | 282834-2
E00012 | Composant | Switch | KMR741NG ULC LFS | SWITCH TACTILE SPST-NO 50MA 32V | C&K | E00012 | V1.00 |  | ADAM LIBRARY.SCHLIB | DigiKey | KMR741NG ULC LFS
E00013 | Composant | Switch | 450405020524 | SMT 8.7 X 3.0 MM MINI SLIDE SWIT | Würth Elektronik | E00013 | V1.00 |  | ADAM LIBRARY.SCHLIB | DigiKey | 450405020524
E00014 | Composant | Connecteur SD | SD CARD CONN | SD CARD READER CONN |  | E00014 | V1.00 |  | ADAM LIBRARY.SCHLIB | Digi-Key | 693071020811
E00015 | Composant | Resistance | 80.6K | RES SMD 80.6K OHM 1% 1/4W 0603 | Vishay Dale | E00015 | V1.00 |  | ADAM LIBRARY.SCHLIB | Newark | ERJ-3EKF8062V
E00016 | Composant | Resistance | 499K | RES SMD 499K OHM 1% 1/4W 0603 | Vishay Dale | E00016 | V1.00 |  | ADAM LIBRARY.SCHLIB | Future Electronics | RC0603FR-07499KL
E00017 | Composant | Resistance | 47K | RES SMD 47K OHM 5% 1/4W 0603 | Vishay Dale | E00017 | V1.00 |  | ADAM LIBRARY.SCHLIB | Future Electronics | AC0603FR-0747KL
E00018 | Composant | Resistance | 21.5K | RES SMD 21.5K OHM 0.1% 1/5W 0603 | Panasonic Electronic Components | E00018 | V1.00 |  | ADAM LIBRARY.SCHLIB | Mouser | CRCW0603321K5FKEA
E00019 | Composant | Infrarouge Receiver | TSOP38338 | Remote Receiver Sensor 38.0kHz 45m Through Hole |  | E00019 | V1.00 |  | ADAM LIBRARY.SCHLIB | Digi-Key | TSOP38338
E00020 | Composant | Resistance | 150R | RES SMD 150 OHM 0.1% 1/8W 0603 | Vishay Beyschlag | E00020 | V1.00 |  | ADAM LIBRARY.SCHLIB | Future Electronics | RC0603FR-07150RL
E00021 | Composant | Resistance | 10K | RES SMD 10K OHM 1% 1/10W 0603 | Rohm Semiconductor | E00021 | V1.00 | E00073 | ADAM LIBRARY.SCHLIB | Future Electronics | RC0603FR-0710KL
E00022 | Composant | Resistance | 100K | RES SMD 100K OHM 1% 1/4W 0603 | Vishay Dale | E00022 | V1.00 |  | ADAM LIBRARY.SCHLIB | Future Electronics | RC0603FR-07100KL
E00023 | Composant | Resistance | 100R | RESISTOR 100 Ohm SMD 1% 1/10W | Yageo | E00023 | V1.00 |  | ADAM LIBRARY.SCHLIB | DigiKey | AC0603FR-10100RL
E00024 | Composant | Resistance | 1.2K | RES SMD 1.2K OHM 1% 1/10W 0603 | Yageo | E00024 | V1.00 |  | ADAM LIBRARY.SCHLIB | DigiKey | RT0603FRE071K2L
E00025 | Composant | Resistance | 4.7K | RES 4.7K OHM 1% 1/10W 0603 | Stackpole Electronics Inc | E00025 | V1.00 |  | ADAM LIBRARY.SCHLIB | Digi-Key | RC0603FR-074K7L
E00026 | Composant | Resistance | 30R | RES 30 OHM 1% 1/3W 0603 | KOA Speer Electronics, Inc. | E00026 | V1.00 |  | ADAM LIBRARY.SCHLIB | DigiKey | SG73P1JTTD30R0F
E00027 | Composant | Resistance | 22.1K | RES 22.1K OHM 1% 1/10W 0603 | Stackpole Electronics Inc | E00027 | V1.00 |  | ADAM LIBRARY.SCHLIB | DigiKey | RMCF0603FT22K1
E00028 | Composant | Resistance | 1K | RES 1K OHM 1% 1/4W 0603 | Yageo | E00028 | V1.00 |  | ADAM LIBRARY.SCHLIB | DigiKey | SR0603FR-7T1KL
E00029 | Composant | Diodes | 1N4007FLTR | STANDARD RECTIFIER 1000V SOD-123 | SMC Diode Solutions | E00029 | V1.00 |  | ADAM LIBRARY.SCHLIB | DigiKey | 1N4007FLTR
E00030 | Composant | Alimentation | AP2112K-3.3TRG1 | REG LINEAIRE 3.3V |  | E00030 | V1.00 |  | ADAM LIBRARY.SCHLIB | Future Electronics | AP2112K-3.3TRG1
E00031 | Composant | Diodes | PMEG2010ER,115 | Diode shotkey |  | E00031 | V1.00 |  | ADAM LIBRARY.SCHLIB | Digi-Key | PMEG2010ER115
E00032 | Composant | Resistance | NA | No resistance, just in case |  | E00032 | V1.00 |  | ADAM LIBRARY.SCHLIB | Digi-Key | RC0603JR-070RL
E00033 | Composant | Alimentation | MP28167GQ-P | Buck-Boost Switching Regulator IC Positive Fixed 5V 1 Output 3A 16-PowerVFQFN |  | E00033 | V1.00 |  | ADAM LIBRARY.SCHLIB | Digi-Key | MP28167GQ-P
E00034 | Composant | Alimentation | MCP73831T-2ACI/OT | Battery lipo charger |  | E00034 | V1.00 |  | ADAM LIBRARY.SCHLIB | Digi-Key | MCP73831T-2ACI/OT
E00035 | Composant | Alimentation | MAX98357AEWL+T | MAX98357AEWL+T |  | E00035 | V1.00 |  | ADAM LIBRARY.SCHLIB |  | MAX98357AEWL+T
E00036 | Composant | Circuit Intégré | LSM6DSMTR | Accelerometer, Gyroscope, Temperature, 6 Axis Sensor I²C, SPI Output |  | E00036 | V1.00 |  | ADAM LIBRARY.SCHLIB | Digi-Key | LSM6DSMTR
E00037 | Composant | Circuit Intégré | LIS3MDLTR | Magnetoresistive Sensor X, Y, Z Axis 12-LGA (2x2) |  | E00037 | V1.00 |  | ADAM LIBRARY.SCHLIB | Digi-Key | LIS3MDLTR
E00038 | Composant | Alimentation | LF50CDT-TR | Linear Voltage Regulator IC Positive Fixed 1 Output 500mA DPAK |  | E00038 | V1.00 |  | ADAM LIBRARY.SCHLIB | Digi-Key | LF50CDT-TR
E00039 | Composant | Alimentation | LDO 5V 1.5A | IC REG LINEAR 5V 1.5A DPAK | STMicroelectronics | E00039 | V1.00 |  | ADAM LIBRARY.SCHLIB | Digi-Key | L7805CDT-TR
E00040 | Composant | Alimentation | LD1117S33TR | IC REG LINEAR 3.3V 800MA SOT223 | STMicroelectronics | E00040 | V1.00 |  | ADAM LIBRARY.SCHLIB | DigiKey | LD1117S33TR
E00041 | Composant | Circuit Intégré | ISD1760SY | Voice Record/Playback IC Multiple Message 40 ~ 120 Sec Pushbutton, SPI 28-SOIC |  | E00041 | V1.00 |  | ADAM LIBRARY.SCHLIB | Digi-Key | ISD1760SY
E00042 | Composant | Inductance | 4.7 µH | FIXED IND 4.7UH 4.6A 53 MOHM SMD | Bourns Inc. | E00042 | V1.00 |  | ADAM LIBRARY.SCHLIB | DigiKey | SRP5030T-4R7M
E00043 | Composant | Fuse | Fuse 500mA | FUSE BOARD MNT 500MA 125VAC/VDC | Schurter Inc. | E00043 | V1.00 |  | ADAM LIBRARY.SCHLIB | DigiKey | 3413.0113.22
E00044 | Composant | Microcontrôleur | ESP32-WROOM-32 (8MB) | ESP32WROOM-32D |  | E00044 | V1.00 |  | ADAM LIBRARY.SCHLIB | Digi-Key | ESP32-WROOM-32D-N4
E00045 | Composant | Circuit Intégré | DRV8837CDSGT | Motor Driver NMOS PWM 8-WSON (2x2) |  | E00045 | V1.00 |  | ADAM LIBRARY.SCHLIB | Digi-Key | DRV8837CDSGT
E00046 | Composant | Switch | Dip Switch 4P | Dip Switch SPST 4 Position Surface Mount Slide (Standard) Actuator 25mA 24VDC | CUI | E00046 | V1.00 |  | ADAM LIBRARY.SCHLIB | Digi-Key | DS04-254-2-04BK-SMT
E00047 | Composant | Infrarouge Transmiter | TSAL6100 | Infrared (IR) Emitter 940nm 1.35V 100mA 80mW/sr @ 100mA 20° Radial, 5mm Dia (T 1 3/4) |  | E00047 | V1.00 |  | ADAM LIBRARY.SCHLIB |  | TSAL6100
E00048 | Composant | USB-UART BRIDGE | CP2104-F03-GMR | USB TO UART CONV |  | E00048 | V1.00 |  | ADAM LIBRARY.SCHLIB | Digi-Key | CP2104-F03-GMR
E00049 | Composant | Connecteur | BM08B-SRSS-TB(LF)(SN) | CONN HEADER SMD 8POS 1MM | JST Sales America Inc. | E00049 | V1.00 |  | ADAM LIBRARY.SCHLIB | DigiKey | BM08B-SRSS-TB(LF)(SN)
E00050 | Composant | Connecteur | B4B-XH-A(LF)(SN) | CONN HEADER VERT 4POS 2.5MM | JST Sales America Inc. | E00050 | V1.00 |  | ADAM LIBRARY.SCHLIB | DigiKey | B4B-XH-A(LF)(SN)
E00051 | Composant | Connecteur | B2B-PH-K-S(LF)(SN) | CONN HEADER VERT 2POS 2MM | JST Sales America Inc. | E00051 | V1.00 |  | ADAM LIBRARY.SCHLIB | DigiKey | B2B-PH-K-S(LF)(SN)
E00052 | Composant | Connecteur | CONN JST 10P SM 90DEG | CONN SM JST 2P |  | E00052 | V1.00 |  | ADAM LIBRARY.SCHLIB | Arrow Electronics | S2B-PH-SM4-TB(LF)(SN)
E00053 | Composant | Connecteur | B10B-PH-K-S(LF)(SN) | CONN HEADER VERT 10POS 2MM | JST Sales America Inc. | E00053 | V1.00 |  | ADAM LIBRARY.SCHLIB | DigiKey | B10B-PH-K-S(LF)(SN)
E00054 | Composant | Connecteur | NPPN041BFCN-RC | CONN HDR 4POS 0.079 GOLD | Sullins Connector Solutions | E00054 | V1.00 |  | ADAM LIBRARY.SCHLIB | DigiKey | NPPN041BFCN-RC
E00055 | Composant | Connecteur | SSW-102-03-T-S | CONN RCPT 2POS 0.1 TIN | Samtec Inc. | E00055 | V1.00 |  | ADAM LIBRARY.SCHLIB | DigiKey | SSW-102-03-T-S
E00056 | Composant | Capaciteur | 4.7 µF | CAP CER 4.7UF 25V X5R 0603 | Samsung Electro-Mechanics | E00056 | V1.00 |  | ADAM LIBRARY.SCHLIB | DigiKey | CL10A475KA8NQNC
E00057 | Composant | Capaciteur | 22nF | CAP CER 22nF 15V 10% 0603, X7R | Taiyo Yuden | E00057 | V1.00 |  | ADAM LIBRARY.SCHLIB | DigiKey | EMF107B7223KAHT
E00058 | Composant | Capaciteur | 1 µF | CAP CER 1UF 16V X7R 0603 | KEMET | E00058 | V1.00 |  | ADAM LIBRARY.SCHLIB | DigiKey | C0603C105K4RACAUTO
E00059 | Composant | Capaciteur | 10 µF | CAP CER 10UF 6.3V X5R 0603 | Murata Electronics | E00059 | V1.00 |  | ADAM LIBRARY.SCHLIB | DigiKey | GRM188R60J106ME47D
E00060 | Composant | Capaciteur | 0.1 µF | CAP CER 0.1UF 50V X7R 0603 | KEMET | E00060 | V1.00 |  | ADAM LIBRARY.SCHLIB | DigiKey | C0603C104K5RAC7411
E00061 | Composant | Capaciteur | 4.7 µF | CAP ALUM 4.7UF 20% 35V SMD | United Chemi-Con | E00061 | V1.00 |  | ADAM LIBRARY.SCHLIB | Mouser | EMVE350ADA4R7MD55G
E00062 | Composant | Capaciteur | 10 µF | CAP ALUM 10UF 20% 16V SMD | Nichicon | E00062 | V1.00 |  | ADAM LIBRARY.SCHLIB | DigiKey | UWX1C100MCL1GB
E00063 | Composant | Capaciteur | 100 µF | CAP ALUM 100UF 20% 50V SMD | Nichicon | E00063 | V1.00 |  | ADAM LIBRARY.SCHLIB | DigiKey | UWT1H101MNL1GS
E00064 | Composant | Capaciteur | 10 µF | CAP CER 10UF 6.3V X5R 0603 |  | E00064 | V1.00 |  | ADAM LIBRARY.SCHLIB | DigiKey | GRM188R60J106ME47D
E00065 | Composant | Alimentation | AP63205 | Buck Switching Regulator IC Positive Fixed 5V 1 Output 2A SOT-23-6 Thin, TSOT-23-6 |  | E00065 | V1.00 |  | ADAM LIBRARY.SCHLIB |  | AP63205WU-7
E00066 | Composant | Switch | AB11AH-HC | SWITCH PUSH SPST-NO 0.4VA 28V | NKK Switches | E00066 | V1.00 |  | ADAM LIBRARY.SCHLIB | DigiKey | AB11AH-HC
E00067 | Composant | Connecteur | PPTC121LFBN-RC | CONN RCPT 12POS 0.1 GOLD PCB | Harwin Inc. | E00067 | V1.00 |  | ADAM LIBRARY.SCHLIB | Digi-Key | PPTC121LFBN-RC
E00068 | Composant | Diodes | Yellow | 0603 YELLOW | American Bright Optoelectronics Corporation | E00068 | V1.00 |  | ADAM LIBRARY.SCHLIB | DigiKey | BL-HKC36D-AV-TRB
E00069 | Composant | Diodes | Red | 0603 RED LED | American Bright Optoelectronics Corporation | E00069 | V1.00 |  | ADAM LIBRARY.SCHLIB | DigiKey | BL-HUB36A-AV-TRB
E00070 | Composant | Diodes | Green | LED GREEN 0603 SMD | Dialight | E00070 | V1.00 |  | ADAM LIBRARY.SCHLIB | DigiKey | 5973316507F
E00071 | Composant | Diodes | Blue | Blue 470nm LED Indication - Discrete 3.3V 0603 (1608 Metric) |  | E00071 | V1.00 |  | ADAM LIBRARY.SCHLIB | Digi-Key | APT1608LVBC/D
E00072 | Composant | Resistance | 10K | RES 0603 10K 1% 1/4W TC, | Bourns Inc. | E00072 | V1.00 | E00021 | ADAM LIBRARY.SCHLIB | DigiKey, | CMP0603-FX-1002ELF
E00073 | Composant | Resistance | 100K | RES 0603 100K 1% 1/4W, | Bourns Inc. | E00073 | V1.00 | E00022 | ADAM LIBRARY.SCHLIB | DigiKey, | CMP0603AFX-1003ELF,
E00074 | Composant | TestPoints | TEST POINTS | RCWCTE TEST POINTS |  | E00074 | V1.00 |  | ADAM LIBRARY.SCHLIB |  | RCWCTE
E00075 | Composant | Cable | CABLE JST 4POS | Cable 4 pos JST |  | E00075 | V1.00 |  | ADAM LIBRARY.SCHLIB | Mouser | 2177961041
E00076 | Composant | Cable | CABLE JST 10POS | Cable 10 pos JST |  | E00076 | V1.00 |  | ADAM LIBRARY.SCHLIB | Digi-Key | A10KR10KR26E254A
E00078 | Composant | Diodes | TVS Diode | TVS DIODE 30.8V 49.9V DO214AC | Taiwan Semiconductor Corporation | E00078 | V1.00 |  | ADAM LIBRARY.SCHLIB | DigiKey | P4SMA36CA R3G
E00079 | Composant | Infrarouge Receiver | TSSP4038 | Remote Receiver Sensor 38.0kHz 45m Through Hole |  | E00079 | V1.00 |  | ADAM LIBRARY.SCHLIB | Digi-Key | TSSP4038
E00080 | Composant | Capaciteur | NA Cap | No capacitor, just in case |  | E00080 | V1.00 |  | ADAM LIBRARY.SCHLIB |  | X
E00081 | Composant | Motion Sensor | PYQ 1548/7660
E00082 | Composant | Temperature Sensor
P00001 | Assemblage | Circuit Electrique | FRONTDOOR_ADAM | Porte de securité front part |  | P00001 | V1.00
P00002 | Assemblage | Circuit Electrique | BACKDOOR_ADAM | Porte de securité back part |  | P00002 | V1.00

Sheet: CATÉGORIES & TYPES
Catégorie | Description | Exemple
Modèle | modèle à utiliser pour la création de documents | modèle de schéma de format "A" avec cartouche normalisée
Exemple | exemple d'utilisation d'éléments de conception | exemple de schéma de format "A" créé à partir du modèle approprié
Composant | Composant électronique | résistance, transistor, circuit imprimé, connecteurs, etc
Librairie | Librairie de composants électroniques | librairie de composants pour un logiciel de dessin de schémas électriques
Assemblage | Assemblage de composants | circuit imprimé sur lequel des pièces ont été soudées et/ou vissées
Mécanique | Composant mécanique | fichiers qui permettent voir un microprocesseur et les circuits qui lui sont connectés comme un seul et même circuit avec lequel un module d'interface peut interagir
Document | Document associé à un produit | fichier qui contient plusieurs fonctions génériques
Ressource | Éléments utilisés pour la création des schémas et assemblage | fichiers contenant des images qui sont reproduites sur des circuits imprimés (logo de compagnie, marques d'approbation)
Externe | Élements utiles provenant de sources externes | librairie de pièces, normes, notes d'application
* | à définir | à utiliser pour indiquer que l'élément n'a pas encore été classifié
Type
résistance
inductance
condensateur
diodes
transistor
del
crystal
batterie
connecteur
régulateur
circuit intégré
assemblage
moteur
circuit imprimé
*
