CamFo/SecurityDoor/Panneau/Altium/ProjetAltium/AdamPannel/Project Outputs for AdamPannel/AdamPannel.xlsx

Comment | Description | Quantity | Manufacturer Part Number 1 | Manufacturer_Part_Number
0.1uF | CAP CER 10UF 10V X6S 0603 | 1 | GRM188C81A106MA73D
1 kOhms | RES SMD 1K OHM 0.1% 1/16W 0603 | 5 | CPF0603B1K0E
4.7 kOhms | RES SMD 4.7K OHM 1% 1/10W 0603 | 1 | RT0603FRE074K7L
4.7K | RES SMD 4.7K OHM 1% 1/10W 0603 | 2 | RT0603FRE074K7L
10 µF | CAP CER 10UF 10V X6S 0603 | 7 | GRM188C81A106MA73D
10 kOhms | RES 10K OHM 0.1% 1/16W 0603 | 3 | RNCS0603BKE10K0
100 kOhms | RES SMD 100K OHM 0.1% 1/16W 0603 | 4 | CPF0603B100KE
100 nF | CAP CER 10UF 10V X6S 0603 | 3 | GRM188C81A106MA73D
693071020811 | No Description Available | 1 | 693071020811
AP2112K-3.3TRG1 | REG LINEAIRE 3.3V | 1 | AP2112K-3.3TRG1
Blue | Blue 470nm LED Indication - Discrete 3.3V 0603 (1608 Metric) | 1 | APT1608LVBC/D
Boost Regulator |  | 1 | MEZD41501A-A
CONN JST 2P SM 90DEG | CONN SM JST 2P | 1 | S2B-PH-SM4-TB(LF)(SN)
CONNECTEUR ÉCRAN |  | 1
CP2104-F03-GMR | No Description Available | 1 | CP2104-F03-GMR
ESP32-WROOM-32 (8MB) | No Description Available | 1 | ESP32-WROOM-32 (8MB)
Green | LED GREEN 0603 SMD | 1 | 5973316507F
HEADER 6 |  | 1
HEADER 10 |  | 1
HEADER 12 |  | 3
ISD1760SY | Voice Record/Playback IC Multiple Message 40 ~ 120 Sec Pushbutton, SPI 28-SOIC | 1 | ISD1760SY
KMR741NG ULC LFS | SWITCH TACTILE SPST-NO 50MA 32V | 2 | KMR741NG ULC LFS
MCP73831T-2ACI/OT | No Description Available | 1 | MCP73831T-2ACI/OT
Micro USB | No Description Available | 1 | 1050170001
MMBT2222ATT1G | TRANS NPN 40V 0.6A SC75-3 | 2 | MMBT2222ATT1G
PMEG2010ER,115 | Diode shotkey | 2 | PMEG2010ER115
Red | 0603 RED LED | 1 | BL-HUB36A-AV-TRB
Yellow | 0603 YELLOW | 1 | BL-HKC36D-AV-TRB
