CamFo/SecurityDoor/Door/Schéma/Fusion 360/Assem3.SLDASM

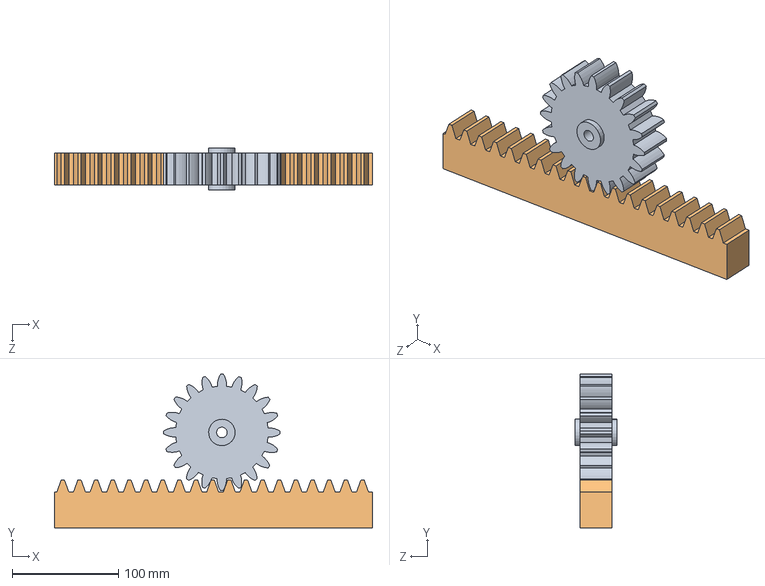
[picture p35: CAD file, 2023-04-25]
Door/Schéma/Fusion 360/Assem3.SLDASM
300.0 x 145.0 x 40.0 mm
spur gear_iso
rack spur rectangular_iso
