CamFo/SecurityDoor/Door/Schéma/Fusion 360/Shaft.step

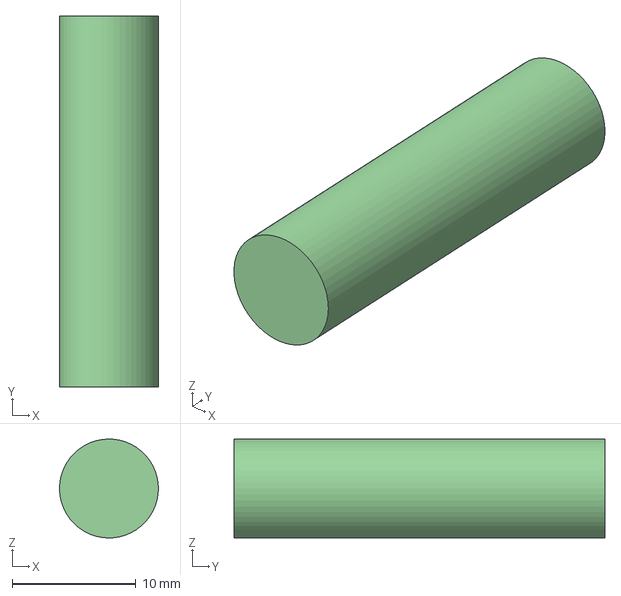
[picture p36: CAD file, 2023-04-25]
Door/Schéma/Fusion 360/Shaft.step
7.99 x 30.0 x 8.00 mm
