CamFo/SecurityDoor/Door/Schéma/Fusion 360/Gear 20 teeth.step

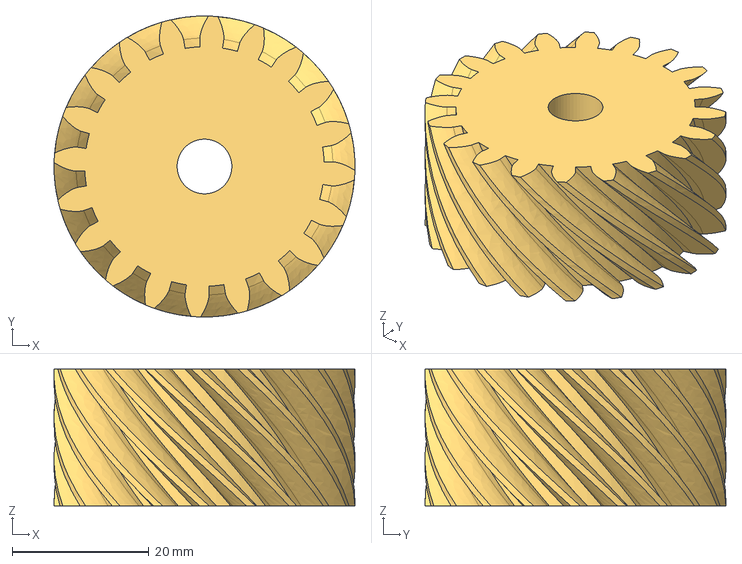
[picture p37: CAD file, 2023-04-25]
Door/Schéma/Fusion 360/Gear 20 teeth.step
44.0 x 44.0 x 20.0 mm
