CamFo/SecurityDoor/Door/Schéma/Fusion 360/NFC.step

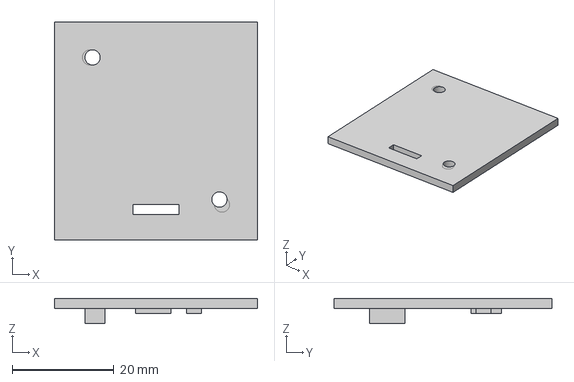
[picture p38: CAD file, 2023-04-25]
Door/Schéma/Fusion 360/NFC.step
40.0 x 43.0 x 5.00 mm
