CamFo/SecurityDoor/Door/Schéma/Fusion 360/Rack Helical.step

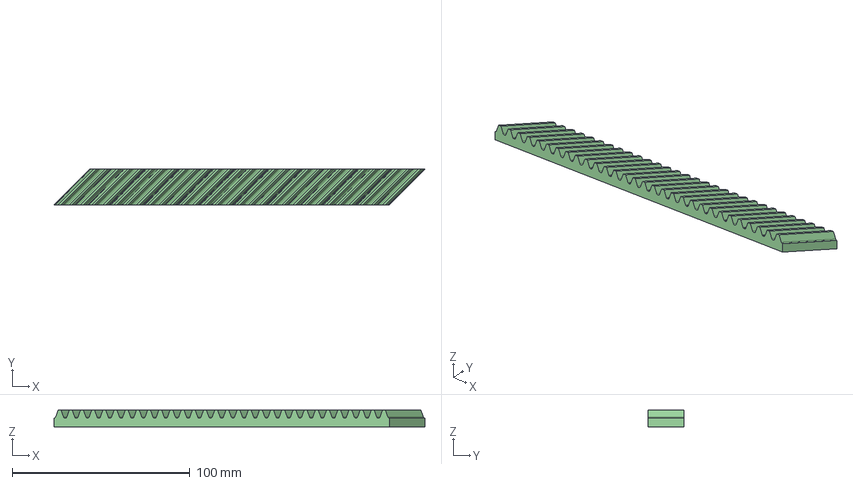
[picture p39: CAD file, 2023-04-25]
Door/Schéma/Fusion 360/Rack Helical.step
208.5 x 20.0 x 9.50 mm
