CamFo/SecurityDoor/Door/Schéma/Fusion 360/ADAM202303_FRONTDOOR.step

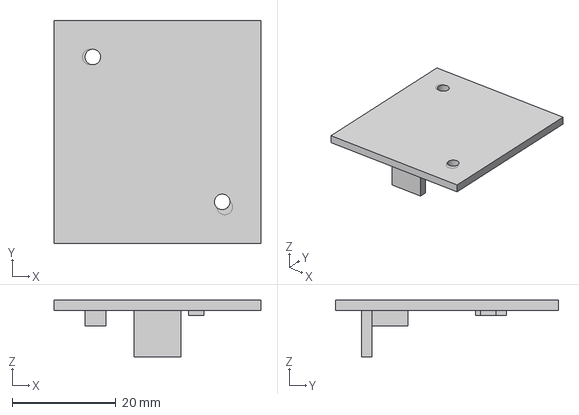
[picture p40: CAD file, 2023-04-25]
Door/Schéma/Fusion 360/ADAM202303_FRONTDOOR.step
40.0 x 43.0 x 11.0 mm
