CamFo/SecurityDoor/Door/Schéma/Fusion 360/Test Gear and rack.stl

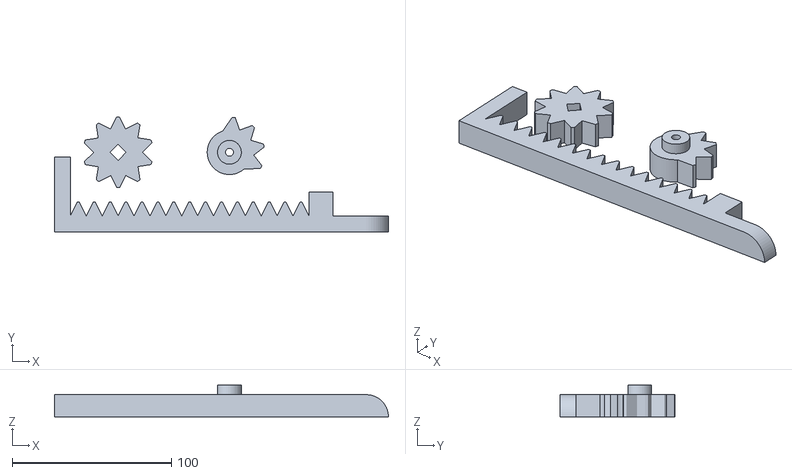
[picture p41: CAD file, 2023-04-25]
Door/Schéma/Fusion 360/Test Gear and rack.stl
210.0 x 72.1 x 20.0
