CamFo/SecurityDoor/Door/Schéma/Fusion 360/Rack and Pinion Gear.step

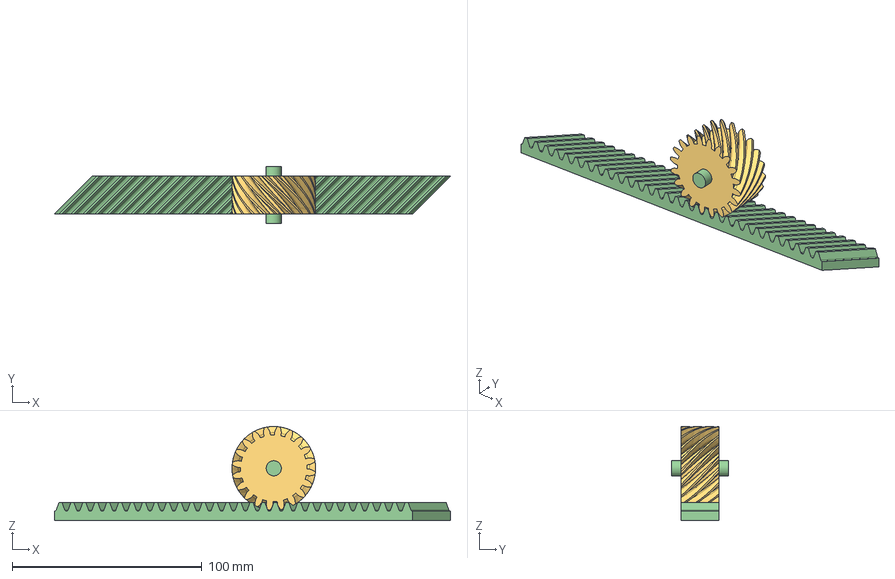
[picture p42: CAD file, 2023-04-25]
Door/Schéma/Fusion 360/Rack and Pinion Gear.step
208.5 x 30.0 x 49.5 mm
Rack Helical
Shaft
Gear 20 teeth_v
