CamFo/SecurityDoor/(list of files, cad)

Other CAD files:
Door/Schéma/Fusion 360/Gear 20 teeth.sldprt
Door/Schéma/Fusion 360/Gear 20 teeth.stl
Door/Schéma/Fusion 360/Rack Helical.sldprt
Door/Schéma/Fusion 360/Rack Helical.stl
Door/Schéma/Fusion 360/Shaft.sldprt
Door/Schéma/Fusion 360/Shaft.stl
