CamFo/SecurityDoor/procedure_de_tests_systeme.xlsx

Procédure de tests système
Date: | 2023-04-27
Responsable: | Camille Fortin et Ilyes
Liste des tests
# spécification | Description | Catégorie | Méthode de test | Tolérances attendues | Tolérances validées | Conforme | notes
E1 | DC-DC batteries lithium a 3.3V | électronique | tester avec source la plage d'entrée 2.7V a 4.3V avec courrant nominal de sortie de 1Ampère | 3.3V +/- 0.1V
E2 | Polyswitch | électronique | Tester si la polyswitch coupe le courant revien correctement | 1.8A coupe |  |  | Attention le test pourrais endommagé la carte
E3 | 5V | électronique | Tester que le 5V peut pousser 1A | 1A
E4 | Rechargement de la Batterie au lithium | électronique | Tester et recharger la batterie au lithium | Recharge Fonctionnel
E5 | Tester la communication avec le PC | électronique | Avoir le port COM | Fonctionne
E6 | Test circuit de Stay On | électronique et logiciel | Pouvoir Shut down avec le software | Fonctionne ON et OFF
E7 | Tester le lecteur de la Carte SD | électronique et logiciel | Pouvoir détecter la carte et lire son ID | Switch et ID
E8 | Communication avec l'écran | électronique et logiciel | Pouvoir afficher et lire le pavé tactile | Tactile et LCD |  |  | Afficher les trois couleur sur chaque pixel
E2/S1 | Circuit de protection de la batterie | électronique et logiciel | Tester avec une source que le circuit ferme a 2.7V | ≤ 2.7V
M1 | Le PCB s'insère parfaitement dans son boitier de plastique | mécanique | Installer le pcb et faire tous les essais fonctionnels
S2 | Communication en ESP-NOW entre la porte et le Pannel | logiciel | vérifier que la communication s'effectue et fonctionne | portée 5 mètres
S3 | Détection du niveau de la batterie | électronique et logiciel | S'assurer de pouvoir lire le ADC et avoir une lecture fiable | 10% tolérance
S4 | Test Audio | électronique et logiciel | S'assurer que l'enregistrement et le speaker fonctionne | Fonctionnel
S5 | Tester les options du panneau | Logiciel | S'assurer que chaque option du panneau soit fonctionnel | 90% |  |  | Option de désactivation des capteurs, changement de code etc.
S6 | Tester la communication Wifi | Logiciel | Communication UDP fonctionnel avec une page web basique | Fonctionnel |  |  | Avoir le serveur web fonctionnel pour se connecter avec des appareils
