CamFo/SecurityDoor/(list of files, drawings)

Other design files:
Capteurs/Altium/AdamCapteurs/AdamCapteurs-1.SchDoc
Capteurs/Altium/AdamCapteurs/AdamCapteurs-2.SchDoc
Capteurs/Altium/AdamCapteurs/AdamCapteurs.PcbDoc
Capteurs/Altium/AdamCapteurs/AdamCapteurs.PrjPcb
Door/Altium/DPIAT202303_DOOR/DPIAT202303_DOOR.PrjPcb
Door/Altium/DPIAT202303_DOOR/Schematics/3DSensor, Magnet.SchDoc
Door/Altium/DPIAT202303_DOOR/Schematics/Alimentation.SchDoc
Door/Altium/DPIAT202303_DOOR/Schematics/DriveMoteur.SchDoc
Door/Altium/DPIAT202303_DOOR/Schematics/Enregistreur et Speaker Audio.SchDoc
Door/Altium/DPIAT202303_DOOR/Schematics/FrontDoorConnecteur.SchDoc
Door/Altium/DPIAT202303_DOOR/Schematics/Infrarouge R&T, LED SMD.SchDoc
Door/Altium/DPIAT202303_DOOR/Schematics/MCU.SchDoc
Door/Altium/DPIAT202303_DOOR/Schematics/NFC.SchDoc
Door/Altium/DPIAT202303_DOOR/Schematics/Top-Sheet.SchDoc
Door/Altium/DPIAT202303_DOOR/Schematics/USB-UART.SchDoc
Door/Altium/DPIAT202304_FRONTDOOR/DPIAT202304_FRONTDOOR/DPIAT202304_FRONTDOOR.PrjPcb
Door/Altium/DPIAT202304_FRONTDOOR/DPIAT202304_FRONTDOOR/PCB/ADAM202303_FRONTDOOR.PcbDoc
Door/Altium/DPIAT202304_FRONTDOOR/DPIAT202304_FRONTDOOR/PCB/Copy of ADAM202303_FRONTDOOR.PcbDoc
Door/Altium/DPIAT202304_FRONTDOOR/DPIAT202304_FRONTDOOR/Schematics/Buzzer, LED.SchDoc
Door/Altium/DPIAT202304_FRONTDOOR/DPIAT202304_FRONTDOOR/Schematics/Enregistreur et Speaker Audio.SchDoc
Door/Altium/DPIAT202304_FRONTDOOR/DPIAT202304_FRONTDOOR/Schematics/FrontDoorConnecteur.SchDoc
Door/Altium/DPIAT202304_FRONTDOOR/DPIAT202304_FRONTDOOR/Schematics/Top-Sheet.SchDoc
Door/Schéma/Multisim/Alimentation 5V to 3V.ms14
Door/Schéma/Multisim/Alimentation 12V to 5V.ms14
Door/Schéma/Multisim/Buzzer Design.ms14
Index Produits/Sheet1.SchDoc
Panneau/Altium/Document feather/Adafruit-HUZZAH32/Adafruit-HUZZAH32/Imported Adafruit HUZZAH32 ESP32 Feather.PrjPcb/Adafruit HUZZAH32 ESP32 Feather.PrjPcb
Panneau/Altium/Document feather/Adafruit-HUZZAH32/Adafruit-HUZZAH32/Imported Adafruit HUZZAH32 ESP32 Feather.PrjPcb/Adafruit HUZZAH32 ESP32 Feather.SchDoc
Panneau/Altium/ProjetAltium/AdamPannel/AdamPannel.PcbDoc
Panneau/Altium/ProjetAltium/AdamPannel/AdamPannel.PrjPcb
Panneau/Altium/ProjetAltium/AdamPannel/Pannel.SchLib
Panneau/Altium/ProjetAltium/AdamPannel/Sheet1.SchDoc
Panneau/Altium/ProjetAltium/AdamPannel/Sheet2.SchDoc
Panneau/Altium/ProjetAltium/AdamPannel/Sheet3.SchDoc
