CamFo/SecurityDoor/Door/Code/Plateform IO/ADAM_DOOR/include/processusControlMoteur.h

/**
 * @file processusControlMoteur.h
 * @author your name (you@domain.com)
 * @brief 
 * @version 0.1
 * @date 2023-05-22
 * 
 * @copyright Copyright (c) 2023
 * 
 */

#ifndef PROCESSUSCONTROLMOTEUR_H
#define PROCESSUSCONTROLMOTEUR_H

//DEFINITIONS REQUISES PAR LE MODULE:
//Dependances materielles
//(copiez et adaptez ce qui suit dans "main.h")
//pas de dependances materielles

//Dependances logicielles
//(copiez et adaptez ce qui suit dans "main.h")


//INFORMATION PUBLIQUE:
//Definitions publiques:
// Structure d'envoie et de réception


//Fonctions publiques:
void processusControlMoteur_initialise(void);

//Variables publiques:
//pas de variables publiques
#endif
