CamFo/SecurityDoor/Capteurs/Programme/CapteurAdam/include/interfaceSHT4X.h

/**
 * @file interfaceSHT4X.h
 * @author Camille Fortin
 * @brief 
 * @version 0.1
 * @date 2023-05-26
 * 
 * @copyright Copyright (c) 2023
 * 
 */
#ifndef INTERFACESHT4X_H
#define INTERFACESHT4X_H

void interfaceSHT4X_initialise(void);


#endif
