CamFo/SecurityDoor/Capteurs/Programme/CapteurAdam/include/piloteSerinPYQ.h

/**
 * @file piloteSerinPYQ.h
 * @author Camille Fortin
 * @brief 
 * @version 0.1
 * @date 2023-05-30
 * 
 * @copyright Copyright (c) 2023
 * 
 */
#ifndef PILOTESERINPYQ_H
#define PILOTESERINPYQ_H



void piloteSerinPYQ_initialise(void);
void piloteSerinPYQ_writeByte(unsigned char value);



#endif
