CamFo/SecurityDoor/Panneau/Programme/PannelESP/src/serviceTaskServer.ino

/**
 * @file serviceTaskServer.ino
 * @author CamFo Camille Fortin (camfortin2022@gmail.com)
 * @brief
 * Program file containing the code defined in xmain.h
 * Please refer to this other file for information necessary in order to make this work.
 * @version 0.1
 * @date 2022-05-03
 * 
 * @copyright Copyright (c) 2022
 * 
 */

//INCLUSIONS
#include <Arduino.h>
#include <TaskScheduler.h>
#define _TASK_MICRO_RES  //requis par TaskScheduler
#include "main.h"
#include "serviceTaskServer.h"

//Definitions privees
//pas de definitions privees
		
//Declarations de fonctions privees:
void serviceTaskServer_neFaitRien(void);
void serviceTaskServer_gereLesTaches(void);

//Definitions de variables privees:
//pas de variables privees


//Definitions de fonctions privees:
void serviceTaskServer_neFaitRien(void)
{
}

void serviceTaskServer_gereLesTaches(void)
{
  serviceTaskServer_execute();
}

//Definitions de variables publiques:
Scheduler serviceTaskServer_gestion; //doit etre defini avant Task pour que ca fonctionne
Task serviceTaskServer_tache(SERVICETASKSERVER_PERIODE_EN_US, TASK_FOREVER,  
    &serviceTaskServer_gereLesTaches, &serviceTaskServer_gestion, true);//doit etre precede de Scheduler
void (*serviceTaskServer_execute)(void);

//Definitions de fonctions publiques:
void serviceTaskServer_DemarreLesTachesALaTouteFinDeSetup(void)
{
	serviceTaskServer_gestion.startNow();  
	serviceTaskServer_gestion.enableAll();  // For high priority   
}

void serviceTaskServer_initialise(void)
{
  serviceTaskServer_execute = serviceTaskServer_neFaitRien;
}
