CamFo/SecurityDoor/Door/Code/Plateform IO/ADAM_DOOR/include/interfaceInfrarouge.h

/**
 * @file interfaceInfrarouge.h
 * @author Ilyes Gharmoul (ilyesdu2002@hotmail.com)
 * @brief 
 * @version 0.1
 * @date 2023-05-18
 * 
 * @copyright Copyright (c) 2023
 * 
 */
#ifndef INTERFACEINFRAROUGE_H
#define INTERFACEINFRAROUGE_H

#define INTERFACEINFRAROUGE_MODULE_EN_FONCTION 1
#define INTERFACEINFRAROUGE_MODULE_PAS_EN_FONCTION 0
#define INTERFACEINFRAROUGE_INFORMATION_DISPONIBLE 1
#define INTERFACEINFRAROUGE_INFORMATION_TRAITEE 0
#define INTERFACEINFRAROUGE_INACTIVE 0
#define INTERFACEINFRAROUGE_ACTIVE  1
#define INTERFACEINFRAROUGE_PAS_EN_FONCTION 2

#define INTERFACEINFRAROUGE_COMPTE_200 200
#define INTERFACEINFRAROUGE_VERIFIEPRESENCE 90
/**
 * @brief 100 pourcent = la barre bloque la communication (débarrer)
 * 
 */
#define INTERFACEINFRAROUGE_PRESENCE_NON_PRESENT 0
/**
 * @brief 0 pourcent = la barre ne bloque pas la communication (barrer)
 * 
 */
#define INTERFACEINFRAROUGE_PRESENCE_PRESENT 1


/// @brief Structure public qui permet de savoir et de changer l'état du module  
typedef struct
{
    bool RequeteActive;
    bool etatDuModuleRecepteur;
    bool etatDuModuleTransmetteur;
    bool etatDesModules;
    bool presence;
    long valeurDistance;
} INTERFACEINFRAROUGE;
void interfaceInfrarouge_initalise();



extern INTERFACEINFRAROUGE interfaceInfrarouge;

#endif
