CamFo/SecurityDoor/Door/Code/Plateform IO/ADAM_DOOR/include/piloteIOEA1.h

/**
 * @file piloteIOEA1.ino
 * @author Ilyes Gharmoul (ilyesdu2002@hotmail.com)
 * @brief Pilote qui contrôle la broche d'un microcontrôleur en utilisant
 *  la librairie Arduino. (digitalWrite et pinMode)
 * 
 * @version 0.1
 * @date 2022-11-23
 * 
 * @copyright Copyright (c) 2022
 * 
 */
#ifndef PILOTEIOEA1_H
#define PILOTEIOEA1_H

//MODULE: piloteIOEA1
//DESCRIPTION: pour permettre la commande d'une sortie en "push-pull" (teste avec ESP32)
// 2022-04-11, Yves Roy, creation

//DEFINITIONS REQUISES PAR LE MODULE:
//Dependances materielles
//(copiez et adaptez ce qui suit dans "main.h")
//#define PILOTEIOEA1_BROCHE 23
//#define PILOTEIOEA1_ETAT_INITIAL_A_UN
//#define PILOTEIOEA1_ETAT_INITIAL_A_ZERO

//Dependances logicielles
//pas de dependances logicielles

//INFORMATION PUBLIQUE:
//Definitions publiques:
// pas de definitions publiques

//Fonctions publiques:

/**
 * @brief Fonction qui met a 5V la broche \ref PILOTEIOEA1_BROCHE du microcontrôleur 
 * 
 */
void piloteIOEA1_metAUn(void);
/**
 * @brief Fonction qui met a 0V la broche \ref PILOTEIOEA1_BROCHE du mirocontrôleur
 * 
 */
void piloteIOEA1_metAZero(void);
/**
 * @brief Fonciton qui met la broche \ref PILOTEIOEA1_BROCHE du mirocontrôleur
 *   au niveau passé en paramètre: 1 ou 0
 * 
 * @param Niveau 
 */
void piloteIOEA1_metA(unsigned char Niveau);
/**
 * @brief Fonction d'initialisation de la broche \ref piloteIOEA1_BROCHE
 *  du mirocontrôleur. Met la broche du microcontrôleur en sortie et assigne
 *  sa valeur initial selon la définition \ref PILOTEIOEA1_ETAT_INITIAL_A_ZERO
 *  ou \ref PILOTEIOEA1_ETAT_INITIAL_A_UN.
 * 
 */
void piloteIOEA1_initialise(void);

//Variables publiques:
//pas de variables publiques
#endif
