CamFo/SecurityDoor/Door/Code/Plateform IO/ADAM_DOOR/src/piloteIOIR2.cpp

/**
 * @file piloteIOIR2.cpp
 * @author Ilyes Gharmoul (ilyesdu2002@hotmail.com)
 * @brief 
 * @version 0.1
 * @date 2023-05-18
 * 
 * @copyright Copyright (c) 2023
 * 
 */
//INCLUSIONS
#include <Arduino.h>
#include "main.h"
#include "piloteIOIR2.h"
#include "pwmWrite.h"
//Definitions privees
//pas de definitions privees

//Declarations de fonctions privees:
//pas de fonctions privees

//Definitions de variables privees:
//pas de variables privees

//Definitions de fonctions privees:
//pas de fonctions privees

//Definitions de variables publiques:
//pas de variables publiques

//Definitions de fonctions publiques:

/**
 * @brief Fonction qui met a 5V la broche \ref piloteIOIR2_BROCHE du microcontrôleur 
 * 
 */
void piloteIOIR2_metAUn(void)
{
  digitalWrite(PILOTEIOIR2_BROCHE, HIGH);
}
/**
 * @brief Fonction qui met a 0V la broche \ref piloteIOIR2_BROCHE du mirocontrôleur
 * 
 */
void piloteIOIR2_metAZero(void)
{
  digitalWrite(PILOTEIOIR2_BROCHE, LOW);
}
/**
 * @brief Fonciton qui met la broche \ref piloteIOIR2_BROCHE du mirocontrôleur
 *   au niveau passé en paramètre: 1 ou 0
 * 
 * @param Niveau 
 */
void piloteIOIR2_metA(unsigned char Niveau)
{
  digitalWrite(PILOTEIOIR2_BROCHE, Niveau);
}

void piloteIOIR2_PWM_AUn()
{
 analogWrite(PILOTEIOIR2_BROCHE,127);
}
void piloteIOIR2_PWM_AZero()
{
 analogWrite(PILOTEIOIR2_BROCHE, 0);
}
/**
 * @brief Fonction d'initialisation de la broche \ref piloteIOIR2_BROCHE
 *  du mirocontrôleur. Met la broche du microcontrôleur en sortie et assigne
 *  sa valeur initial selon la définition \ref piloteIOIR2_ETAT_INITIAL_A_ZERO
 *  ou \ref piloteIOIR2_ETAT_INITIAL_A_UN.
 * 
 */
void piloteIOIR2_initialise(void)
{
  pinMode(PILOTEIOIR2_BROCHE,OUTPUT);
  analogWriteFrequency(38000);
#ifdef PILOTEIOIR2_ETAT_INITIAL_A_UN
	digitalWrite(PILOTEIOIR2_BROCHE,HIGH);	
#endif

#ifdef PILOTEIOIR2_ETAT_INITIAL_A_ZERO
	digitalWrite(PILOTEIOIR2_BROCHE,LOW);
#endif
}
