CamFo/SecurityDoor/Door/Code/Arduino INO/Test/PN532_I2C_Test/PN532-PN532_HSU/PN532_I2C_Test/PN532_I2C_Test.ino

#include <Wire.h>
#include "PN532_I2C.h"
#include "PN532.h"
#include "NfcAdapter.h"
PN532_I2C pn532_i2c(Wire);
NfcAdapter nfc = NfcAdapter(pn532_i2c);
String tagId = "None";
byte nuidPICC[4];
 
void setup(void) 
{
 Serial.begin(115200);
 Serial.println("System initialized");
 nfc.begin();
}
 
void loop() 
{
 readNFC();
}
 
void readNFC() 
{
 if (nfc.tagPresent())
 {
   NfcTag tag = nfc.read();
   tag.print();
   tagId = tag.getUidString();
 }
 delay(5000);
}
