CamFo/SecurityDoor/(commit log)

2023-03-20 Initial commit test
    [DPIAT2023_DOORKNOB.PrjPcb]
2023-03-21 Folder added
    [DPIAT2023_DOORKNOB.PrjPcb]
2023-03-21 Create DPIAT202303_DOOR.PrjPcb
    Creation of project altium
    [DPIAT202303_DOOR.PrjPcb]
2023-03-21 Test
    Test
    [Test.SchDoc]
2023-03-21 Project Set
    [DPIAT202303_DOOR.PrjPcb, Test1.SchDoc]
2023-03-21 Ajout de Shematic et de Architecture
    [Adafruit HUZZAH32 ESP32 Feather.brd, Adafruit HUZZAH32 ESP32 Feather.sch]
2023-03-21 Added Shematic and pcb of ESP32 feather
    [Adafruit HUZZAH32 ESP32 Feather.PrjPcb, Adafruit HUZZAH32 ESP32 Feather.SchDoc]
2023-03-21 Ajoute Footprint ESP32
    [Test1.SchDoc]
2023-03-21 Modification des architectures
    [Sheet1.SchDoc]
2023-03-22 Added schematic pages
    [DPIAT202303_DOOR.PrjPcb, MCU.SchDoc]
2023-03-22 Added schematics
    [Alimentation.SchDoc, Buzzer,LED,Infrared Receptor.SchDoc, Camera.SchDoc, MCU.SchDoc, MotorCtrl.SchDoc, NFC.SchDoc, Recorder, speaker.SchDoc]
2023-03-22 Reupdate schema
    [DPIAT202303_DOOR.PrjPcb]
2023-03-22 Début Projet Altium
    [Adafruit HUZZAH32 ESP32 Feather.PrjPcb, Adafruit HUZZAH32 ESP32 Feather.SchDoc, Adafruit HUZZAH32 ESP32 Feather.brd, Adafruit HUZZAH32 ESP32 Feather.sch, AdamPannel.PrjPcb, Sheet1.SchDoc]
2023-03-22 Test Avant de Merge
    [ESP32-WROOM-32_8MB_.PcbLib, ESP32-WROOM-32_8MB_.SchLib]
2023-03-22 To remove error
    [Adafruit HUZZAH32 ESP32 Feather.PrjPcb, Adafruit HUZZAH32 ESP32 Feather.SchDoc, Adafruit HUZZAH32 ESP32 Feather.brd, Adafruit HUZZAH32 ESP32 Feather.sch, Sheet1.SchDoc]
2023-03-23 Updated MCU and added proper design for Buzzer
    [DPIAT202303_DOOR.PrjPcb]
2023-03-23 Ajout des librairies Altium du Pannel
    [ESP32-WROOM-32_8MB_.PcbLib, ESP32-WROOM-32_8MB_.SchLib, Pannel.SchLib, Sheet1.SchDoc]
2023-03-23 Library management + editing schematics
    [Buzzer Design.ms14]
2023-03-23 update schematics
2023-03-23 Added 3Ds for gear and rack
    [Gear 20 teeth.sldprt, Gear 20 teeth.step, Gear 20 teeth.stl, Rack Helical.sldprt, Rack Helical.step, Rack Helical.stl, Rack and Pinion Gear.step, Shaft.sldprt]
2023-03-24 Update 3D models
    [Assem3.SLDASM]
2023-03-24 Added ports and schematics
    [Test Gear and rack.stl]
2023-03-28 Updated schematics + Library
    [Alimentation.SchDoc, Buzzer, LED, Infrarrouge.SchDoc, DriveMoteur.SchDoc, MCU.SchDoc, USB-UART.SchDoc]
2023-03-28 schema update xd
    [Alimentation.SchDoc, Buzzer, LED, Infrarrouge.SchDoc, DPIAT202303_DOOR.PrjPcb, DriveMoteur.SchDoc, MCU.SchDoc, USB-UART.SchDoc]
2023-03-29 Moitié du shcematic
    [Adafruit HUZZAH32 ESP32 Feather.SchDoc, AdamPannel.PrjPcb, Sheet1.SchDoc, Sheet2.SchDoc]
2023-03-29 Reupdate schem + added lib
    [Speaker et enregistreur.SchDoc]
2023-03-29 Changed Mic + speaker with gyro
    [Alimentation.SchDoc, Buzzer, LED, Infrarrouge.SchDoc, DPIAT202303_DOOR.PrjPcb, DoorComponantsTest.PcbDoc, DriveMoteur.SchDoc, MCU.SchDoc, MultiEnvironnemental_Sensor.SchDoc, NFC.SchDoc]
2023-03-29 Updated schem, added more to lib, added a temp pc to check footprints
2023-03-30 Added 3D sensor + magnet sensor and updated all schematics as a whole
    [3DSensor, Magnet.SchDoc, DPIAT202303_DOOR.PrjPcb, DriveMoteur.SchDoc, MCU.SchDoc, MultiEnvironnemental_Sensor.SchDoc, NFC.SchDoc, Top-Sheet.SchDoc, USB-UART.SchDoc]
2023-03-30 Updated lib + schem
    [3DSensor, Magnet.SchDoc, Alimentation.SchDoc, Buzzer, LED, Infrarrouge.SchDoc, DPIAT202303_DOOR.PrjPcb, DriveMoteur.SchDoc, MCU.SchDoc, NFC.SchDoc, USB-UART.SchDoc]
2023-03-30 Updated schema and footprint
    [Buzzer, LED, Infrarrouge.SchDoc, DPIAT202303_DOOR.PrjPcb, NFC.SchDoc, USB-UART.SchDoc]
2023-03-30 Ajout du lipo charger
    [Sheet1.SchDoc, Sheet2.SchDoc]
2023-03-31 Updated Everything, changed power, removed MPAP, removed variations, nfc needs change, 3D sensor page added stuff
    [3DSensor, Magnet.SchDoc, Alimentation.SchDoc, Buzzer, LED, Infrarrouge.SchDoc, Camera.SchDoc, DPIAT202303_DOOR.PrjPcb, DriveMoteur.SchDoc, MCU.SchDoc, NFC.SchDoc]
2023-03-31 Changed Capacitors, moved ios, added more inputs for chips etc.
    [3DSensor, Magnet.SchDoc, Alimentation.SchDoc, Buzzer, LED, Infrarrouge.SchDoc, DriveMoteur.SchDoc, MCU.SchDoc, USB-UART.SchDoc]
2023-04-03 Reupdated la stratégie du NFC et speakerbuzzer
    [Front Board.PcbDoc, Top-Sheet.SchDoc]
2023-04-04 Update Shematic
    [Sheet1.SchDoc, Sheet2.SchDoc]
2023-04-04 Updated schematic
    [3DSensor, Magnet.SchDoc, Alimentation.SchDoc, Buzzer, LED, Infrarrouge.SchDoc, DPIAT202303_DOOR.PrjPcb, DriveMoteur.SchDoc, Enregistreur et Speaker Audio.SchDoc, MCU.SchDoc, NFC.SchDoc]
2023-04-06 Shémas Presque Fini
    [Adafruit HUZZAH32 ESP32 Feather.SchDoc, Sheet1.SchDoc, Sheet2.SchDoc]
2023-04-06 updated schematics added notes
    [3DSensor, Magnet.SchDoc, Alimentation.SchDoc, Buzzer, LED, Infrarrouge.SchDoc, DPIAT202303_DOOR.PrjPcb, DriveMoteur.SchDoc, MCU.SchDoc, USB-UART.SchDoc]
2023-04-06 Updated schematics, added notes
2023-04-08 Finalisation du shémas
    [Sheet1.SchDoc, Sheet2.SchDoc]
2023-04-08 Projet Save
    [AdamPannel.PrjPcb]
2023-04-10 Separated whole project, replaced things in lib, added a singular library for components, etc
    [Alimentation.SchDoc, Buzzer, LED, Infrarrouge.SchDoc, DPIAT202303_DOOR.PrjPcb, DriveMoteur.SchDoc, FrontDoorConnecteur.SchDoc, Infrarouge R&T, LED SMD.SchDoc, MCU.SchDoc, Top-Sheet.SchDoc]
2023-04-11 Reupdated some components link, created a singular lib for every single components but diode IR and receptor, need to check for FRONTDOOR, not done yet.(?)
    [3DSensor, Magnet.SchDoc, Alimentation.SchDoc, DPIAT202303_DOOR.PrjPcb, DriveMoteur.SchDoc, FrontDoorConnecteur.SchDoc, Infrarouge R&T, LED SMD.SchDoc, MCU.SchDoc, USB-UART.SchDoc]
2023-04-11 Reupdated some components link, created a singular lib for every single components but diode IR and receptor, need to check for FRONTDOOR, not done yet.(?)
    Reupdated some components link, created a singular lib for every single components but diode IR and receptor, need to check for FRONTDOOR, not done yet.(?)
    [Buzzer, LED.SchDoc, DPIAT202304_FRONTDOOR.PrjPcb, Enregistreur et Speaker Audio.SchDoc, FrontDoorConnecteur.SchDoc, NFC.SchDoc, Top-Sheet.SchDoc, _RAlimentation.SchDoc, _RBuzzer, LED, Infrarrouge.SchDoc]
2023-04-11 Added bom, updated schem and lib
    [Buzzer, LED.SchDoc, DPIAT202304_FRONTDOOR.PrjPcb, Enregistreur et Speaker Audio.SchDoc, FrontDoorConnecteur.SchDoc, USB-UART.SchDoc]
2023-04-11 Drive Speaker et Diode TVS
2023-04-11 Drive I2S et Diode TVS
    [Sheet1.SchDoc, Sheet2.SchDoc]
2023-04-11 Push before the merge
    [3DSensor, Magnet.SchDoc, Alimentation.SchDoc, Buzzer, LED.SchDoc, DPIAT202303_DOOR.xlsx, DPIAT202304_FRONTDOOR.PrjPcb, DPIAT202304_FRONTDOOR.xlsx, DPIAT202304_FRONTDOOR_CELESTIAL.xlsx, DriveMoteur.SchDoc]
2023-04-11 Updated Lib added test points
    [3DSensor, Magnet.SchDoc, Alimentation.SchDoc, DPIAT202303_DOOR.PrjPcb, DriveMoteur.SchDoc, FrontDoorConnecteur.SchDoc, Infrarouge R&T, LED SMD.SchDoc, MCU.SchDoc, Top-Sheet.SchDoc]
2023-04-11 Update SCH
    [AdamPannel.PrjPcb, Sheet1.SchDoc, Sheet2.SchDoc]
2023-04-11 Updated schem, added ADAM INVENTORY NUMBER Param
    [3DSensor, Magnet.SchDoc, Alimentation.SchDoc, DriveMoteur.SchDoc, Enregistreur et Speaker Audio.SchDoc, FrontDoorConnecteur.SchDoc, Infrarouge R&T, LED SMD.SchDoc, MCU.SchDoc, Top-Sheet.SchDoc]
2023-04-11 Added test points on schematics, updated parameters in lib
    [3DSensor, Magnet.SchDoc, Alimentation.SchDoc, DPIAT202303_DOOR.PrjPcb, DriveMoteur.SchDoc, FrontDoorConnecteur.SchDoc, Infrarouge R&T, LED SMD.SchDoc, MCU.SchDoc, Top-Sheet.SchDoc]
2023-04-11 Shémas presque Final
    [AdamPannel.PrjPcb, Sheet2.SchDoc]
2023-04-11 jai mal a tete
    [3DSensor, Magnet.SchDoc, Alimentation.SchDoc, Buzzer, LED.SchDoc, DPIAT202303_DOOR.PrjPcb, DPIAT202304_FRONTDOOR.PrjPcb, DriveMoteur.SchDoc, Enregistreur et Speaker Audio.SchDoc, FrontDoorConnecteur.SchDoc]
2023-04-11 Final version of schematics for 2023-04-11 before Review
    [Alimentation.SchDoc, Buzzer, LED.SchDoc, DPIAT202304_FRONTDOOR.PrjPcb, Enregistreur et Speaker Audio.SchDoc, FrontDoorConnecteur.SchDoc, Infrarouge R&T, LED SMD.SchDoc, Top-Sheet.SchDoc]
2023-04-11 Sch pas mal fini
    [Sheet1.SchDoc, Sheet2.SchDoc]
2023-04-12 Esti 11h
    [AdamPannel.PrjPcb, Sheet1.SchDoc, Sheet2.SchDoc]
2023-04-12 Sch Final Mercredi
    [Sheet1.SchDoc, Sheet2.SchDoc]
2023-04-13 Added footprint on PCB
    [3DSensor, Magnet.SchDoc, ADAM202303_BACKDOOR.PcbDoc, Alimentation.SchDoc, DPIAT202303_DOOR.PrjPcb, DoorComponantsTest.PcbDoc, DriveMoteur.SchDoc, Front Board.PcbDoc, FrontDoorConnecteur.SchDoc]
2023-04-13 Added PCB footprints
    [ADAM202303_FRONTDOOR.PcbDoc, Buzzer, LED.SchDoc, DPIAT202304_FRONTDOOR.PrjPcb, Enregistreur et Speaker Audio.SchDoc]
2023-04-13 Début du PCB
    [PCB1.PcbDoc, Sheet1.SchDoc, Sheet2.SchDoc, Sheet3.SchDoc]
2023-04-13 TOUS les footprints son présent
    [AdamPannel.PrjPcb, PCB1.PcbDoc, Sheet1.SchDoc, Sheet2.SchDoc, Sheet3.SchDoc]
2023-04-13 PCB commencé
    [PCB1.PcbDoc]
2023-04-13 PCB,SCHEM,FOOTPRINTS UPDATES
    [ADAM202303_BACKDOOR.PcbDoc, ADAM202303_FRONTDOOR.PcbDoc, Alimentation.SchDoc, Buzzer, LED.SchDoc, DPIAT202303_DOOR.PrjPcb, DPIAT202304_FRONTDOOR.PrjPcb, DriveMoteur.SchDoc, FrontDoorConnecteur.SchDoc]
2023-04-14 Updated PCB
    [ADAM202303_FRONTDOOR.PcbDoc]
2023-04-14 Finished PCB, Imported components on backdoor pcb, need to check some footprint and design
    [3DSensor, Magnet.SchDoc, ADAM202303_BACKDOOR.PcbDoc, ADAM202303_FRONTDOOR.PcbDoc, ADAM202303_FRONTDOOR.step, Alimentation.SchDoc, Buzzer, LED.SchDoc, DPIAT202304_FRONTDOOR.PrjPcb, DriveMoteur.SchDoc]
2023-04-17 updated PCB backdoor
    [ADAM202303_FRONTDOOR.PcbDoc, Alimentation.SchDoc, Buzzer, LED.SchDoc, DPIAT202304_FRONTDOOR.PrjPcb, Enregistreur et Speaker Audio.SchDoc, FrontDoorConnecteur.SchDoc, Infrarouge R&T, LED SMD.SchDoc, MCU.SchDoc]
2023-04-18 PCB placement
    [PCB1.PcbDoc]
2023-04-18 PCB fait a 50%
    [PCB1.PcbDoc]
2023-04-18 Footprint ajouté
    [Sheet1.SchDoc]
2023-04-18 Ajout Switch
    [Sheet1.SchDoc, Sheet2.SchDoc, Sheet3.SchDoc]
2023-04-18 PCB avec power switch
    [PCB1.PcbDoc, Sheet1.SchDoc, Sheet2.SchDoc, Sheet3.SchDoc]
2023-04-18 Mounting hole made
    [PCB1.PcbDoc, Sheet1.SchDoc]
2023-04-18 Placed components on PCB Backdoor
    [DPIAT202303_DOOR.PrjPcb, DriveMoteur.SchDoc, Infrarouge R&T, LED SMD.SchDoc, MCU.SchDoc, Top-Sheet.SchDoc]
2023-04-18 Routing Commencé
    [PCB1.PcbDoc, Sheet3.SchDoc]
2023-04-18 Updated schem, added notes to do and PCB reviewed by Etienne!
    [3DSensor, Magnet.SchDoc, ADAM202303_FRONTDOOR.PcbDoc, Alimentation.SchDoc, Buzzer, LED.SchDoc, DPIAT202303_DOOR.PrjPcb, DPIAT202304_FRONTDOOR.PrjPcb, DriveMoteur.SchDoc, Enregistreur et Speaker Audio.SchDoc]
2023-04-19 PCB placé
    [PCB1.PcbDoc, Sheet1.SchDoc]
2023-04-19 Début routing
    [PCB1.PcbDoc, Sheet2.SchDoc, Sheet3.SchDoc]
2023-04-19 Started rooting PCB BACKDOOR, Un-net'd extra connectors
    [3DSensor, Magnet.SchDoc, Alimentation.SchDoc, DPIAT202303_DOOR.PrjPcb, DriveMoteur.SchDoc, FrontDoorConnecteur.SchDoc, Infrarouge R&T, LED SMD.SchDoc, MCU.SchDoc, Top-Sheet.SchDoc]
2023-04-19 Pret a route
    [PCB1.PcbDoc, Sheet1.SchDoc, Sheet2.SchDoc]
2023-04-19 rooting pcb 36/77
2023-04-20 Routing 80%
    [PCB1.PcbDoc]
2023-04-20 Routing encore a 80%
    [PCB1.PcbDoc]
2023-04-20 Routing va finir un jour
    [PCB1.PcbDoc, Sheet2.SchDoc, Sheet3.SchDoc]
2023-04-20 Routing presque fini
    [PCB1.PcbDoc, Sheet2.SchDoc, Sheet3.SchDoc]
2023-04-20 Finalised rooting of backdoor PCB, needs correction.
    [FrontDoorConnecteur.SchDoc]
2023-04-20 Ajout du 40 Pin
2023-04-20 Découpage Board
    [PCB1.PcbDoc, Sheet2.SchDoc]
2023-04-20 Borad replacé
    [PCB1.PcbDoc]
2023-04-20 Détail sur shématic
    [PCB1.PcbDoc, Sheet1.SchDoc, Sheet2.SchDoc, Sheet3.SchDoc]
2023-04-21 Shémas Vérifié
    [PCB1.PcbDoc, Sheet1.SchDoc, Sheet2.SchDoc, Sheet3.SchDoc]
2023-04-21 Gerber made.
    [ADAM202303_BACKDOOR.GBL, ADAM202303_BACKDOOR.GBO, ADAM202303_BACKDOOR.GBP, ADAM202303_BACKDOOR.GBS, ADAM202303_BACKDOOR.GKO, ADAM202303_BACKDOOR.GTL, ADAM202303_BACKDOOR.GTO, ADAM202303_BACKDOOR.GTP]
2023-04-24 PCB compatile avec écran recu
    [AdamPannel.PrjPcb, PCB1.PcbDoc, Sheet1.SchDoc, Sheet2.SchDoc]
2023-04-24 PCB fini de router
    [PCB1.PcbDoc]
2023-04-24 Correction du DRC
    [PCB1.PcbDoc]
2023-04-25 Clearance a 5 mils réglé
    [PCB1.PcbDoc]
2023-04-25 Coin courbé avec keep out outline
    [PCB1.PcbDoc]
2023-04-25 Reste 43 erreur sur drc
    [PCB1.PcbDoc]
2023-04-25 PCB reste à imprimer et double check
    [PCB1.PcbDoc, Sheet1.SchDoc]
2023-04-25 updated index
    [ADAM202303_BACKDOOR.GBL, ADAM202303_BACKDOOR.GBO, ADAM202303_BACKDOOR.GBP, ADAM202303_BACKDOOR.GBS, ADAM202303_BACKDOOR.GKO, ADAM202303_BACKDOOR.GTL, ADAM202303_BACKDOOR.GTO, ADAM202303_BACKDOOR.GTP]
2023-04-25 Reste juste les erreur fucker des keep out de TVS
    [PCB1.PcbDoc]
2023-04-25 Hole changé
    [PCB1.PcbDoc]
2023-04-25 Hole vérifié
    [PCB1.PcbDoc]
2023-04-25 Reduced size of git rep for branch
    [3DSensor, Magnet.SchDoc, Alimentation.SchDoc, Buzzer, LED.SchDoc, DriveMoteur.SchDoc, Enregistreur et Speaker Audio.SchDoc, FrontDoorConnecteur.SchDoc, Infrarouge R&T, LED SMD.SchDoc, MCU.SchDoc]
2023-04-25 Détail PCB
    [PCB1.PcbDoc]
2023-04-25 ENNNNCore des modif sur le shémas
    [PCB1.PcbDoc, Sheet1.SchDoc]
2023-04-26 Nouveau bipolaire
    [Sheet1.SchDoc]
2023-04-26 PCB FINAL
    [PCB1.PcbDoc, Sheet1.SchDoc, Sheet2.SchDoc]
2023-04-26 PCB finale reste juste erreur des TVS
    [AdamPannel.PrjPcb, PCB1.PcbDoc, Sheet1.SchDoc]
2023-04-26 Top overlay modifié
    [PCB1.PcbDoc]
2023-04-27 PCB FINI commit avant de merge
    [AdamPannel.PcbDoc, PCB1.PcbDoc]
2023-04-27 PCB FINAL commit avant de merge
    [AdamPannel.PcbDoc, AdamPannel.PrjPcb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]
2023-04-27 Rajout des lib pour essayer de merge comme du monde
2023-04-27 Commit avec les donné du main
    [3DSensor, Magnet.SchDoc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]
2023-04-27 Remove de lib to pull the lib from main
2023-04-27 Ajout des librairies apres les avoir combiné
    [INDEX_EQUIPE_ILYES_CAMILLE.xlsx]
2023-04-27 Commit juste pour etre capable de merge AVEC LE MAIN
    [INDEX_EQUIPE_ILYES_CAMILLE.xlsx]
2023-04-27 Ajout de la Procédure de Test
    [procedure_de_tests_systeme.xlsx]
2023-04-28 test with I2C for NFC
    [INDEX_EQUIPE_ILYES_CAMILLE.xlsx]
2023-04-28 Procédure de test Fini
    [procedure_de_tests_systeme.xlsx]
2023-04-28 removed useless stuff
    [DPIAT202303_DOOR.PrjPcb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]
2023-04-30 Début du projet Altium sur la branche Capteurs
    [AdamCapteurs-1.SchDoc, AdamCapteurs-2.SchDoc, AdamCapteurs.PrjPcb]
2023-04-30 Ajout des IO du ESP dans projet Altium Capteurs
    [AdamCapteurs-2.SchDoc]
2023-05-02 Shémas Capteurs pas mal fini
    [AdamCapteurs-1.SchDoc, AdamCapteurs-2.SchDoc, AdamCapteurs.PrjPcb, Sheet1.SchDoc]
2023-05-02 Shémas Fini reste vérification Document PCB créé
    [AdamCapteurs-1.SchDoc, AdamCapteurs-2.SchDoc, AdamCapteurs.PcbDoc, AdamCapteurs.PrjPcb]
2023-05-02 Update du schématic Capteurs
    [AdamCapteurs-1.SchDoc, AdamCapteurs-2.SchDoc, AdamPannel.PrjPcb]
2023-05-02 Shémas Fini
    [AdamCapteurs-1.SchDoc, AdamCapteurs-2.SchDoc]
2023-05-02 Updated code, added exemples and stuff
    [INDEX_EQUIPE_ILYES_CAMILLE.xlsx]
2023-05-02 Première Commit pour le Programme du Panneau de Contrôle
2023-05-03 placement components on pbc, need to discuss matter of footprint and potential design flaws
    [AdamCapteurs-2.SchDoc, AdamCapteurs.PcbDoc, AdamCapteurs.PrjPcb]
2023-05-03 Finished routing, need verification and handling of footprint by camille
    [AdamCapteurs.PcbDoc]
2023-05-03 PCB fini a checker
    [AdamCapteurs-1.SchDoc, AdamCapteurs-2.SchDoc, AdamCapteurs.PcbDoc, AdamCapteurs.PrjPcb]
2023-05-03 Code avec Base de temps Fonctionnel
2023-05-03 PCB capteur prêt à fariquer
    [AdamCapteurs.PrjPcb]
2023-05-03 trying to figure out why arduino sucks
2023-05-04 Résolutions du DRC
    [AdamCapteurs.PcbDoc]
2023-05-04 Ordre dans les part Number
    [AdamCapteurs-1.SchDoc, AdamCapteurs-2.SchDoc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]
2023-05-04 Presque plus de trace d'arduino Ciboire
2023-05-05 Worked on interface and pilot fixing, issue with I2C and machine a etat
    [PN532.h, interfacePN523.cpp, interfacePN523.h, main.h, main.ino, piloteI2C.h, piloteIOT1.cpp, processusClignotant.cpp]
2023-05-11 Added pilote and interace + power point update
2023-05-11 power point update
2023-05-11 Commit avant de switch au capteur
2023-05-15 PILOTE ESPNOW presque terminé
    [Sheet1.SchDoc]
2023-05-15 deleted button, updated pilots, still fixing rgb
    [interfaceEntree1.cpp, interfaceMoteur.cpp, interfaceMoteur.h, main.h, main.ino, piloteI2C.cpp, processusPourTest.cpp]
2023-05-15 updated pilotes, deleted button, bug with blue RGB
    [interfaceRGB.cpp]
2023-05-15 RGB code works, need to fix hardware
    [processusPourTest.cpp, processusPourTest.h]
2023-05-15 RGB WORKS, NEED TO FIX HARDWARE
    [main.ino]
2023-05-16 test input io14, blue won't work on V1 hardware
    [main.h, piloteEntree1.h, processusPourTest.cpp, processusPourTest.h]
2023-05-16 Service Fonctionnel reste a optimiser et à tester la com avec la door
2023-05-17 made interfaceRGB BDT (basedetemps) & fixed GPIO?
    [interfaceMoteur.cpp, interfaceMoteur.h, interfaceRGB.cpp, interfaceRGB.h, main.h, main.ino, processusClignotant.cpp, processusClignotant.h]
2023-05-17 updated name files + added buzzer need test
    [interfaceBuzzer.cpp, interfaceBuzzer.h, interfaceMoteur.cpp, interfaceMoteur.h, interfaceRGB.cpp, interfaceRGB.h, main.h, main.ino]
2023-05-19 Completion de l'interface IR
2023-05-21 LCD fonctionnel avec début des fonctions pour faire des lignes
2023-05-21 Ajout des pilote et interface Témoin Vert Clean du pilote Tactile
2023-05-21 Pavé tactile lu à chaque 8ms par la base de temps
2023-05-21 interface LCD fonctionnel débu des fonctions de forme
2023-05-22 ServiceCommunication fonctionnel avec 3 ESP32
2023-05-22 Communication fonctionnel avec affichage à l'Écran de l'état des modules. Reste des petit bug de délais d'affichage
    [ServiceCommunication.cpp, interfaceLCD.cpp, interfaceLCD.h, piloteESPNOWCapteur.cpp, piloteESPNOWDoor.cpp]
2023-05-23 Fixing minor bug service Communication
    [piloteESPNOWCapteur.cpp]
2023-05-23 Fixing minor Bug Service Communicaiton
    [ServiceCommunication.cpp, interfaceLCD.h, main.ino, piloteESPNOWDoor.cpp]
2023-05-23 COMMUNICATOIN FONCTIONNEL avec pannel et 2 ESP32
2023-05-24 Manque a tester le processus, fix ERREUR STATE
    [AnnexeADAM.h, ServiceCommunication.cpp, ServiceCommunication.h, interfaceRGB.cpp, main.h, piloteESPNOW.cpp, processusControlMoteur.cpp, processusGestionPairing.cpp]
2023-05-24 Tout fonctionnel avec le deuxième Core sauf avec la lecture tactile
2023-05-25 Base de temps a 5ms avec pavé tactile Com sur CPU0
2023-05-25 update moteur to not work past 180 deg
    [AnnexeADAM.h, ServiceCommunication.cpp, interfaceMoteur.cpp, interfaceMoteur.h, main.h, piloteESPNOW.cpp, processusControlMoteur.cpp, processusGestionPairing.cpp]
2023-05-25 Fonctionnement du control des moteurs par ESPNOW
2023-05-26 Ajout de la phase Processus Panneau
2023-05-28 Tableau de Caractère Gras généré par chatGPT
2023-05-29 Ajout de linterface Motion et du pilote Direct Link
2023-05-29 Update de l'interfaceLCD - bouton Relief
2023-05-31 Changement de define pour la com et ajout de délais
2023-05-31 Prework before adjusting motor lock
2023-05-31 on a conqueris les demons pour l'instant
2023-05-31 produit de l'année 10000$ pas negociable
2023-06-01 Probleme d'envoie Barre/Debarre règler
    [ServiceCommunication.cpp, ServiceCommunication.h, interfaceTactile.cpp]
2023-06-01 Capteur de mouvement foncionnel
2023-06-01 works with my powerbank
2023-06-07 Led du Motion Sensor
